Alexhuge1/fftai_alexbotmini/1_Mechanic/Alexbotmini_V1.0/back.jpg

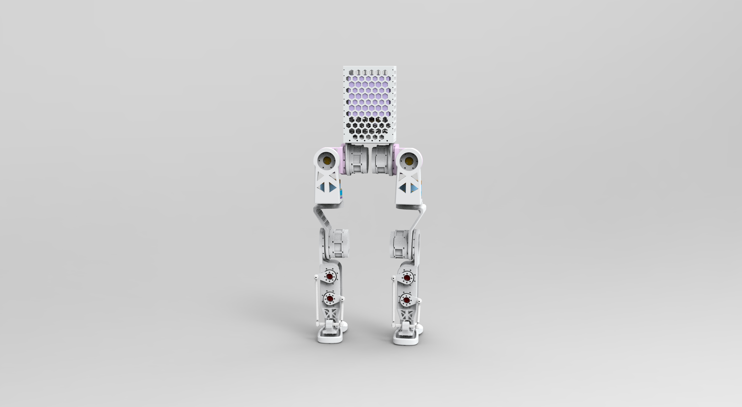
1_Mechanic/Alexbotmini_V1.0/back.jpg
