Alexhuge1/fftai_alexbotmini/1_Mechanic/Alexbotmini_V1.0/CNCchange/crotch修改.png

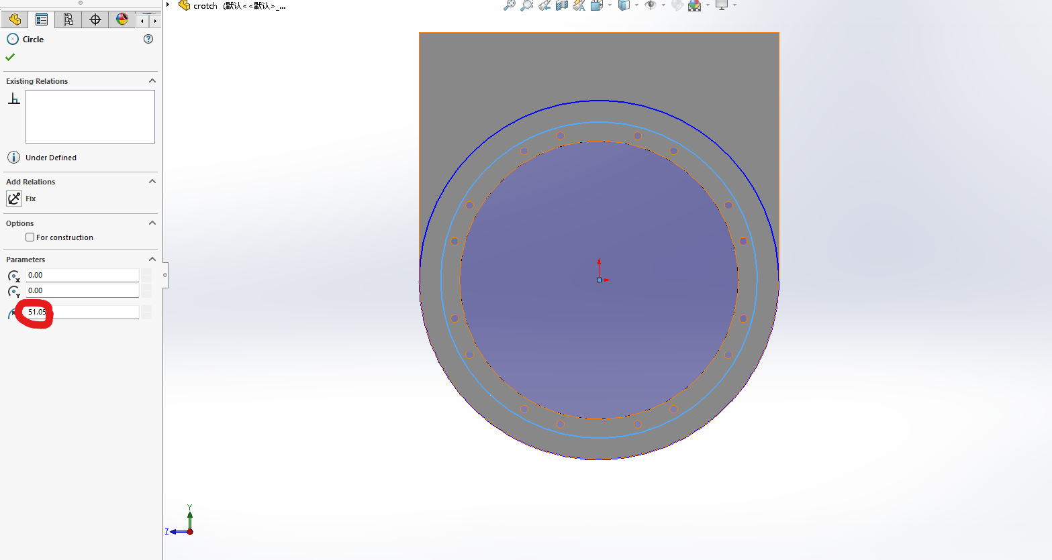
1_Mechanic/Alexbotmini_V1.0/CNCchange/crotch修改.png
