Alexhuge1/fftai_alexbotmini/1_Mechanic/Alexbotmini_V1.0/CNCchange/fsa60修改.png

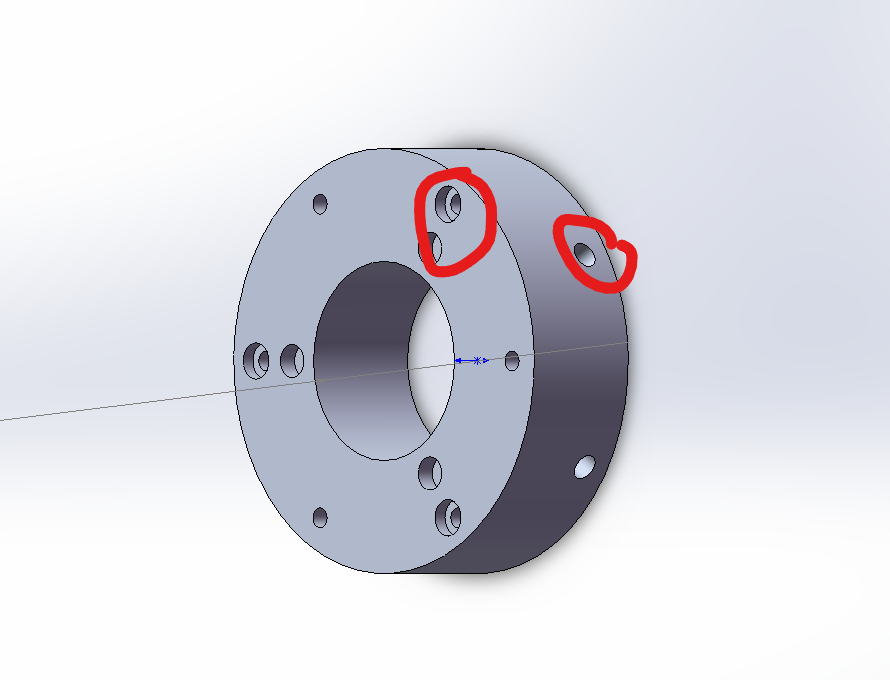
1_Mechanic/Alexbotmini_V1.0/CNCchange/fsa60修改.png
