Alexhuge1/fftai_alexbotmini/1_Mechanic/Alexbotmini_V1.0/for_cnc(unchanged)/SW转PDF字体/软件安装教程、详细安装方法.png

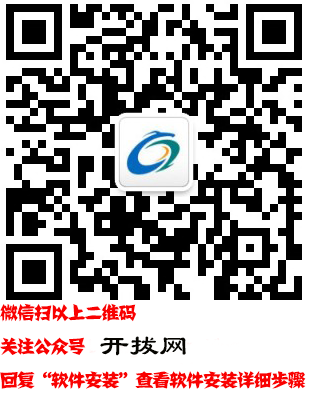
1_Mechanic/Alexbotmini_V1.0/for_cnc(unchanged)/SW转PDF字体/软件安装教程、详细安装方法.png
