Alexhuge1/fftai_alexbotmini/1_Mechanic/Alexbotmini_V1.0/upperbody(without yaw)/电路模型/48v转5v/转压.png

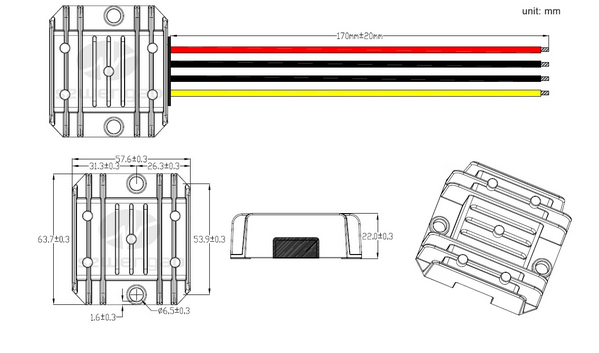
1_Mechanic/Alexbotmini_V1.0/upperbody(without yaw)/电路模型/48v转5v/转压.png
