Alexhuge1/fftai_alexbotmini/1_Mechanic/Alexbotmini_V1.0/upperbody(without yaw)/电路模型/imu/屏幕截图 2024-09-07 170201.png

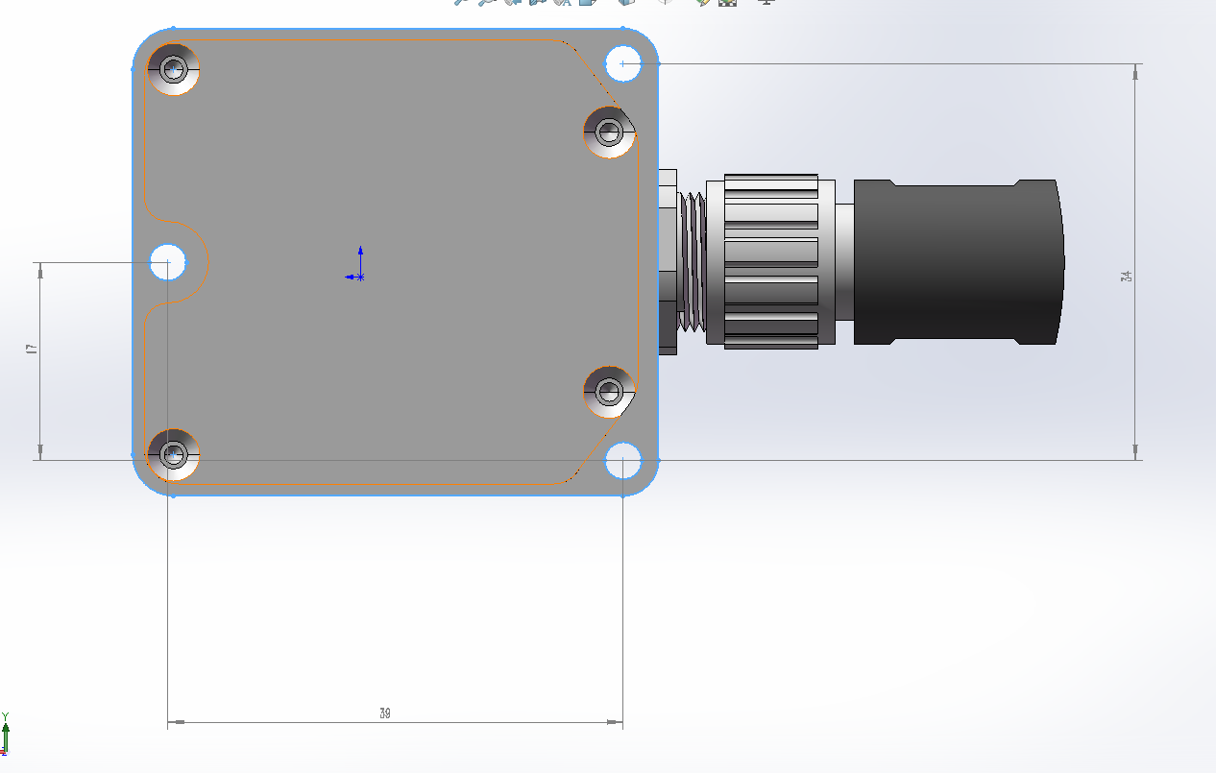
1_Mechanic/Alexbotmini_V1.0/upperbody(without yaw)/电路模型/imu/屏幕截图 2024-09-07 170201.png
