Alexhuge1/fftai_alexbotmini/1_Mechanic/Alexbotmini_V1.0/upperbody(without yaw)/电路模型/上位机/jetsonnano.png

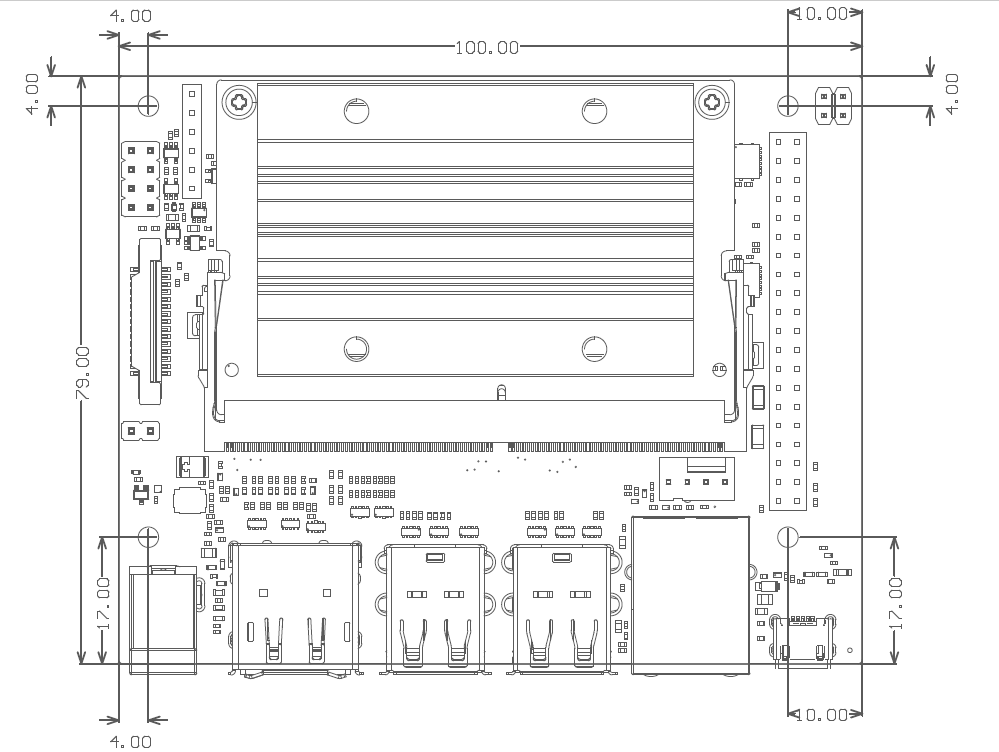
1_Mechanic/Alexbotmini_V1.0/upperbody(without yaw)/电路模型/上位机/jetsonnano.png
