Alexhuge1/fftai_alexbotmini/1_Mechanic/alexbotminipage/keyshot.23/files/xr_cursor.gif

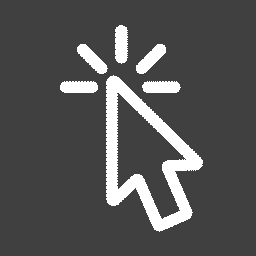
1_Mechanic/alexbotminipage/keyshot.23/files/xr_cursor.gif
