Alexhuge1/fftai_alexbotmini/2_Firmware/joystick/ps5手柄.jpg

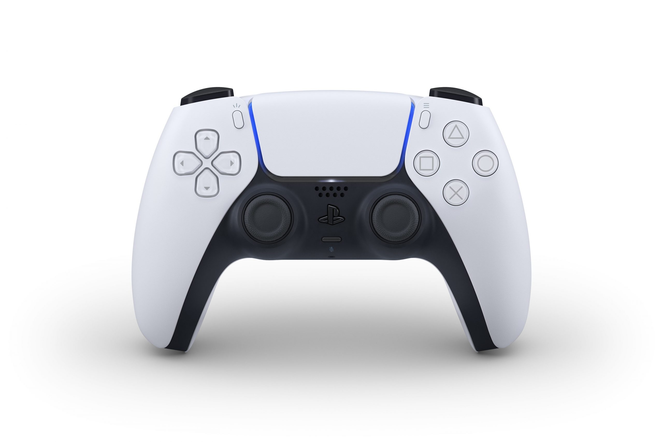
2_Firmware/joystick/ps5手柄.jpg
