Alexhuge1/fftai_alexbotmini/6_Photos/alexbotmini(3D).jpg

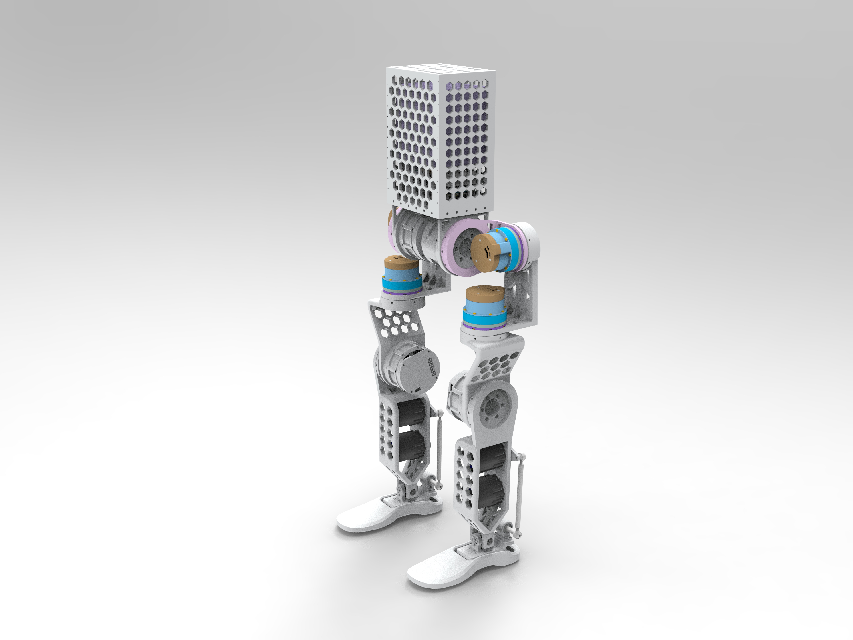
6_Photos/alexbotmini(3D).jpg
