Alexhuge1/fftai_alexbotmini/6_Photos/alexbotmini_stand.jpg

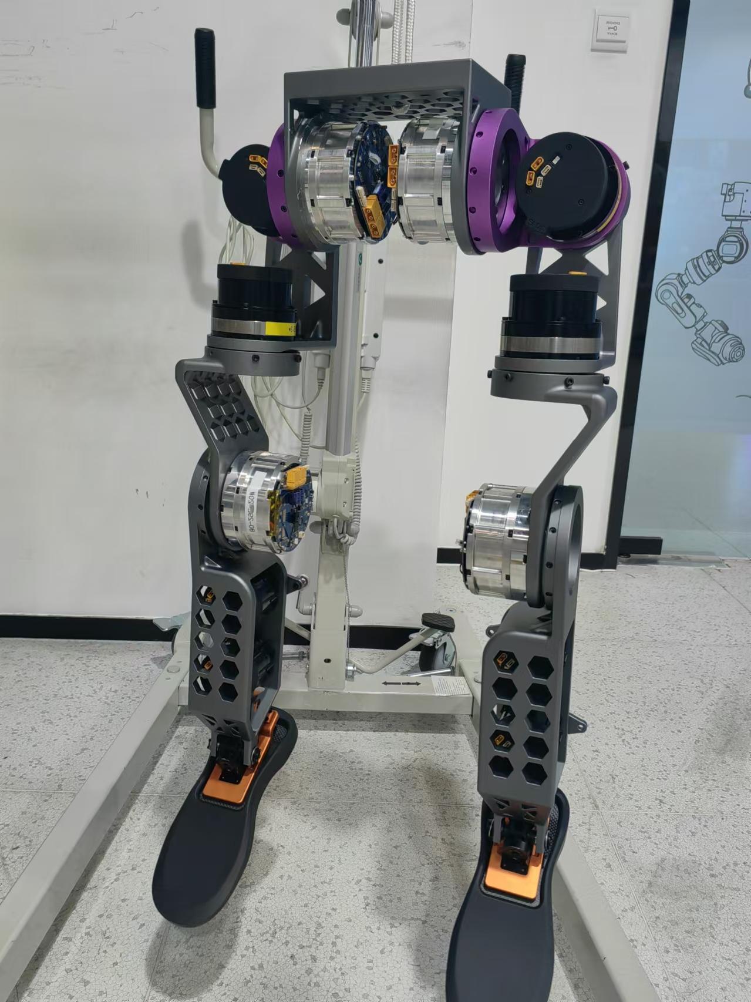
6_Photos/alexbotmini_stand.jpg
