Alexhuge1/fftai_alexbotmini/6_Photos/V1lowerbody.jpg

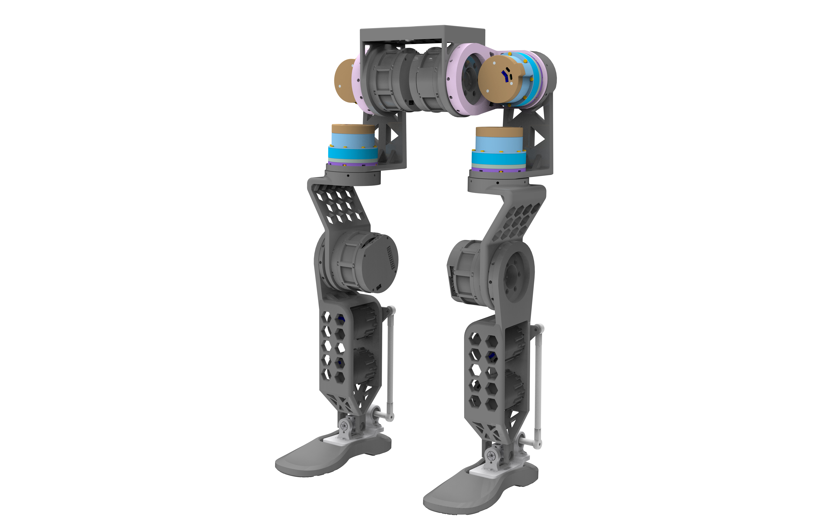
6_Photos/V1lowerbody.jpg
