Alexhuge1/fftai_alexbotmini/6_Photos/身高尺寸图.png

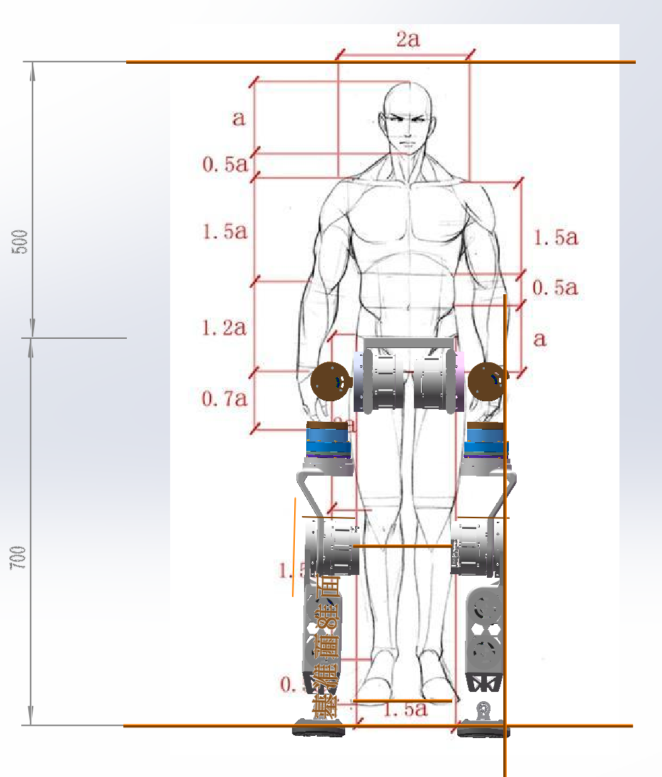
6_Photos/身高尺寸图.png
