Alexhuge1/fftai_alexbotmini/1_Mechanic/alexbotmini_urdf/alexbotmini/meshes/leftlink4.STL

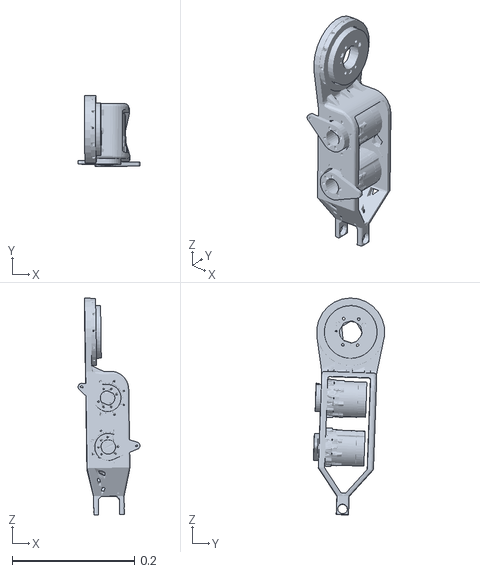
[picture p39: CAD file, 2024-08-29]
1_Mechanic/alexbotmini_urdf/alexbotmini/meshes/leftlink4.STL
0.101 x 0.116 x 0.355
