Alexhuge1/fftai_alexbotmini/1_Mechanic/Alexbotmini_V1.0/CNCchange/crotch.STEP

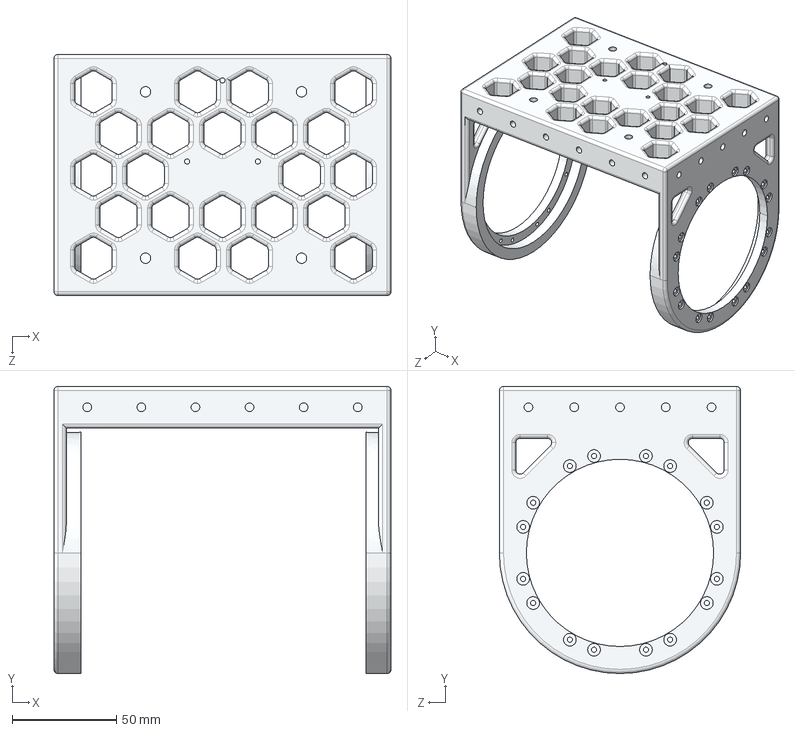
[picture p40: CAD file, 2024-12-02]
1_Mechanic/Alexbotmini_V1.0/CNCchange/crotch.STEP
162.0 x 138.0 x 116.0 mm
