Alexhuge1/fftai_alexbotmini/1_Mechanic/Alexbotmini_V1.0/for_cnc(unchanged)/3D/back.SLDPRT

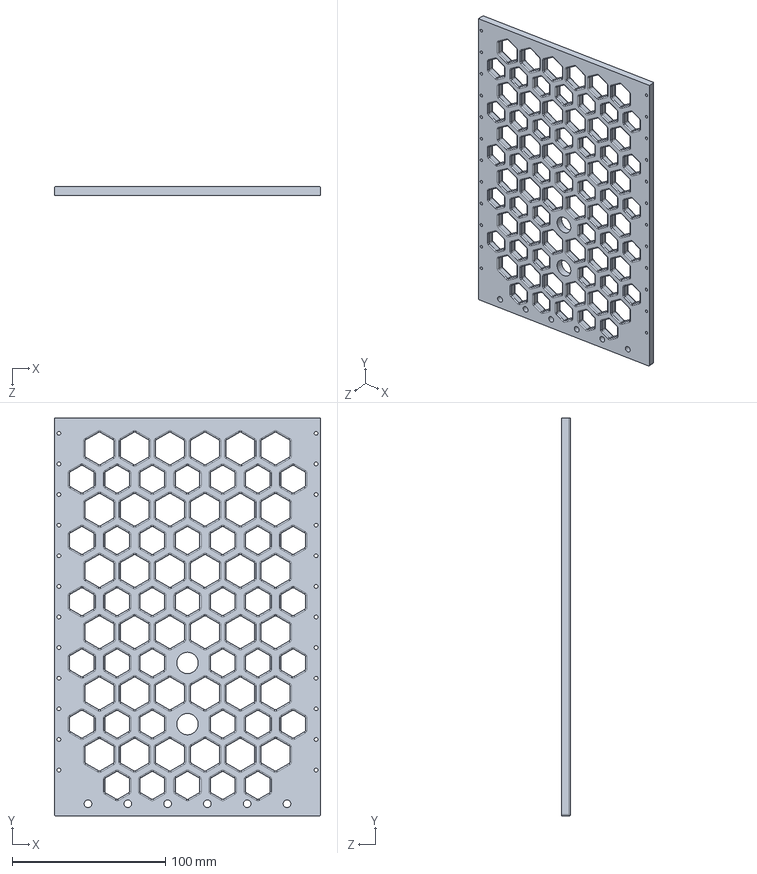
[picture p41: CAD file, 2024-09-12]
1_Mechanic/Alexbotmini_V1.0/for_cnc(unchanged)/3D/back.SLDPRT
174.0 x 260.0 x 6.00 mm
