Alexhuge1/fftai_alexbotmini/1_Mechanic/Alexbotmini_V1.0/upperbody(without yaw)/front.SLDPRT

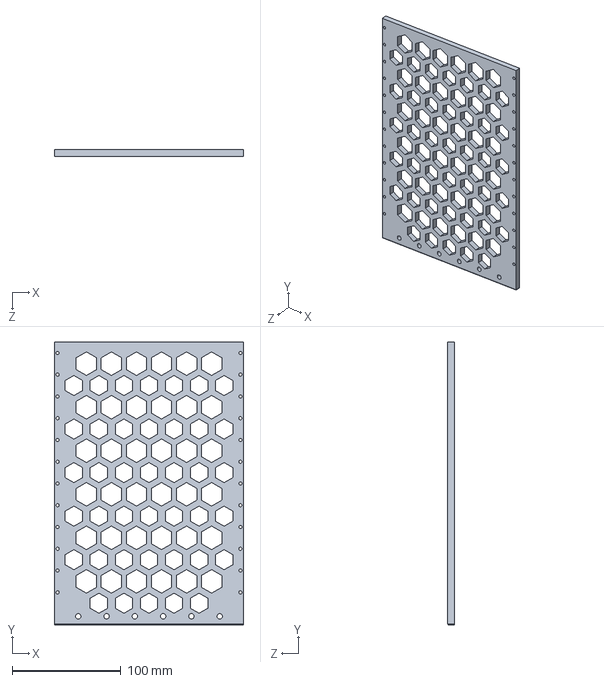
[picture p42: CAD file, 2024-09-10]
1_Mechanic/Alexbotmini_V1.0/upperbody(without yaw)/front.SLDPRT
174.0 x 260.0 x 6.00 mm
