Alexhuge1/fftai_alexbotmini/1_Mechanic/Alexbotmini_V1.0/upperbody(without yaw)/电路模型/48v转5v/转压.SLDPRT

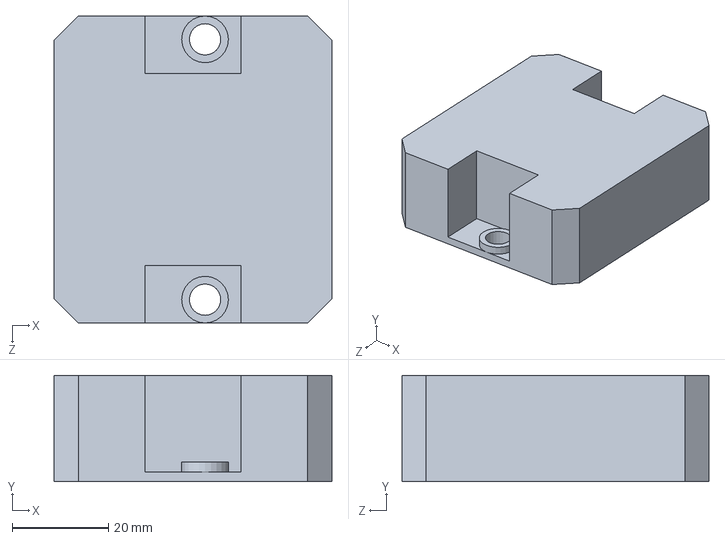
[picture p43: CAD file, 2024-09-09]
1_Mechanic/Alexbotmini_V1.0/upperbody(without yaw)/电路模型/48v转5v/转压.SLDPRT
57.6 x 22.0 x 63.7 mm
