Alexhuge1/fftai_alexbotmini/1_Mechanic/Alexbotmini_V1.0/upperbody(without yaw)/电路模型/imu/imu.SLDPRT

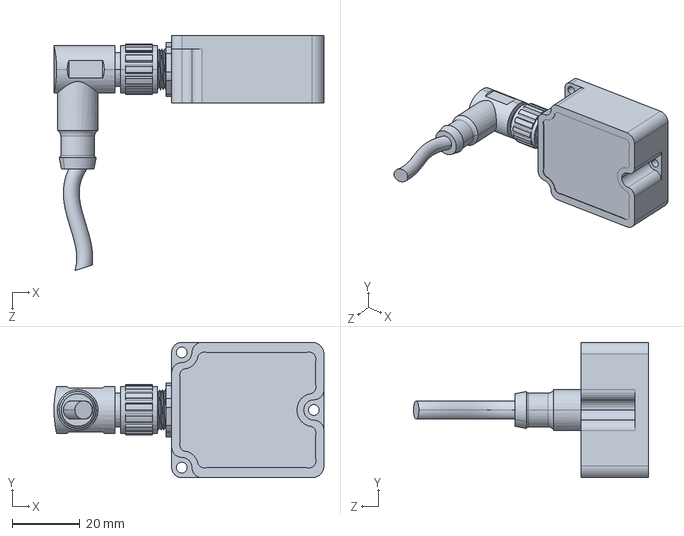
[picture p44: CAD file, 2024-09-09]
1_Mechanic/Alexbotmini_V1.0/upperbody(without yaw)/电路模型/imu/imu.SLDPRT
79.8 x 40.0 x 69.5 mm
