Alexhuge1/fftai_alexbotmini/1_Mechanic/Alexbotmini_V1.0/upperbody(without yaw)/电路模型/上位机/螺柱.SLDPRT

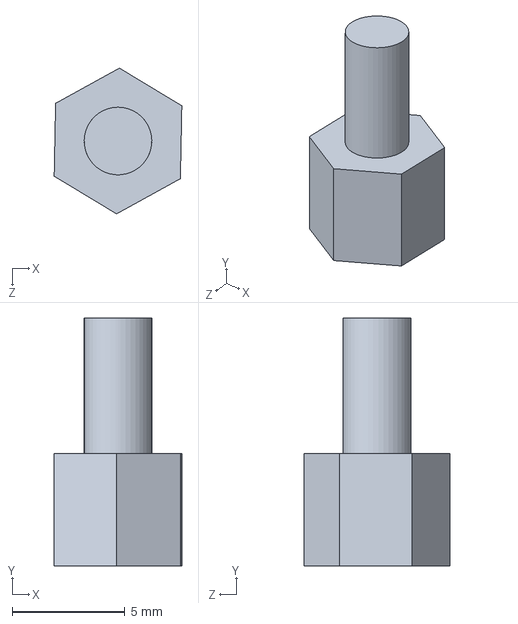
[picture p45: CAD file, 2024-09-09]
1_Mechanic/Alexbotmini_V1.0/upperbody(without yaw)/电路模型/上位机/螺柱.SLDPRT
5.66 x 11.0 x 6.47 mm
