Alexhuge1/fftai_alexbotmini/1_Mechanic/Alexbotmini_V1.0/wholebody/thigh2.SLDPRT

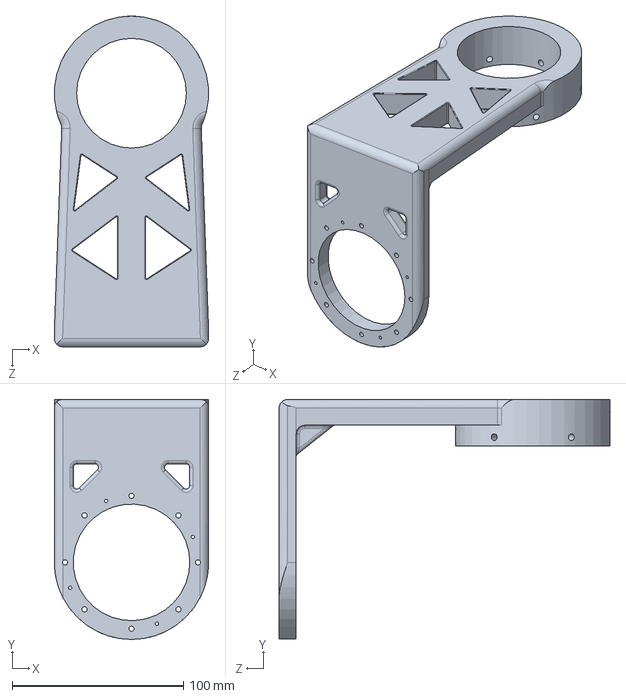
[picture p46: CAD file, 2024-11-27]
1_Mechanic/Alexbotmini_V1.0/wholebody/thigh2.SLDPRT
90.0 x 140.0 x 193.0 mm
