Alexhuge1/fftai_alexbotmini/3_Walk and trot/humanoid-gym/resources/robots/alexbotmini/meshes/base_link.STL

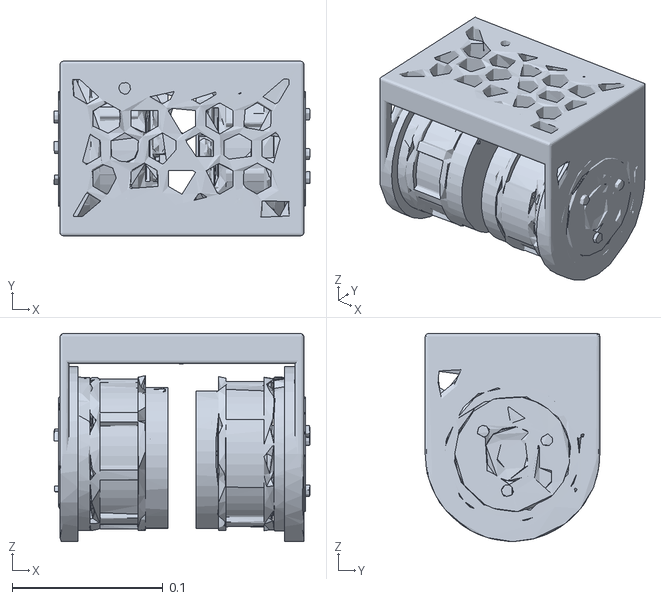
[picture p47: CAD file, 2024-08-29]
3_Walk and trot/humanoid-gym/resources/robots/alexbotmini/meshes/base_link.STL
0.17 x 0.116 x 0.138
