Alexhuge1/fftai_alexbotmini/3_Walk and trot/humanoid-gym/resources/robots/XBot/meshes/left_ankle_roll_link.STL

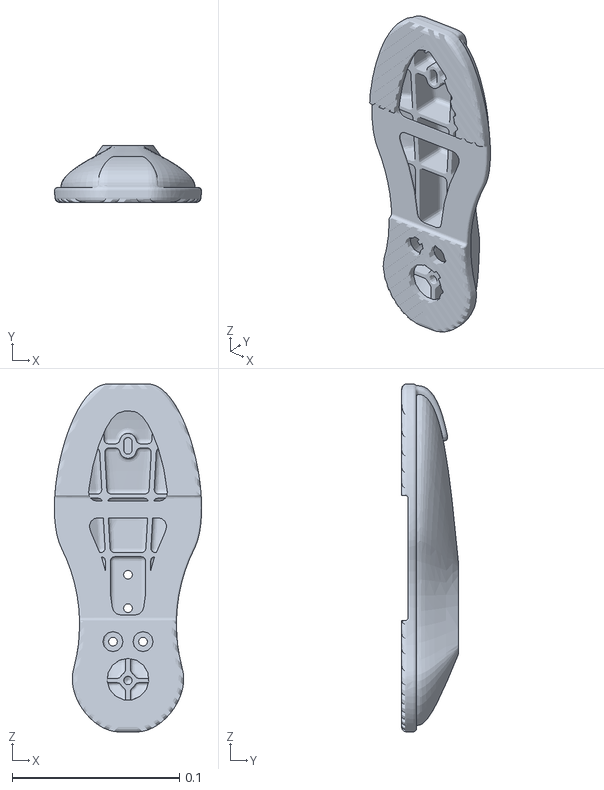
[picture p48: CAD file, 2024-08-29]
3_Walk and trot/humanoid-gym/resources/robots/XBot/meshes/left_ankle_roll_link.STL
0.088 x 0.034 x 0.208
