Alexhuge1/fftai_alexbotmini/3_Walk and trot/humanoid-gym/resources/robots/XBot/urdf/right_hand_ring_tip.STL

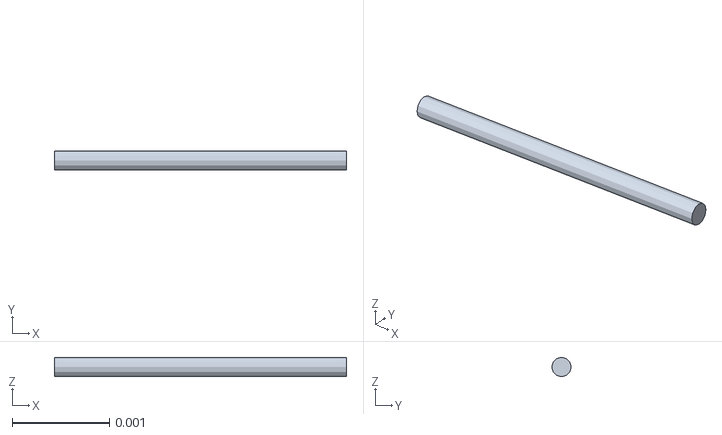
[picture p49: CAD file, 2024-08-29]
3_Walk and trot/humanoid-gym/resources/robots/XBot/urdf/right_hand_ring_tip.STL
0.003 x 0.0002 x 0.0002
