Alexhuge1/fftai_alexbotmini/1_Mechanic/alexbotmini_urdf/alexbotmini/meshes/leftlink2.STL

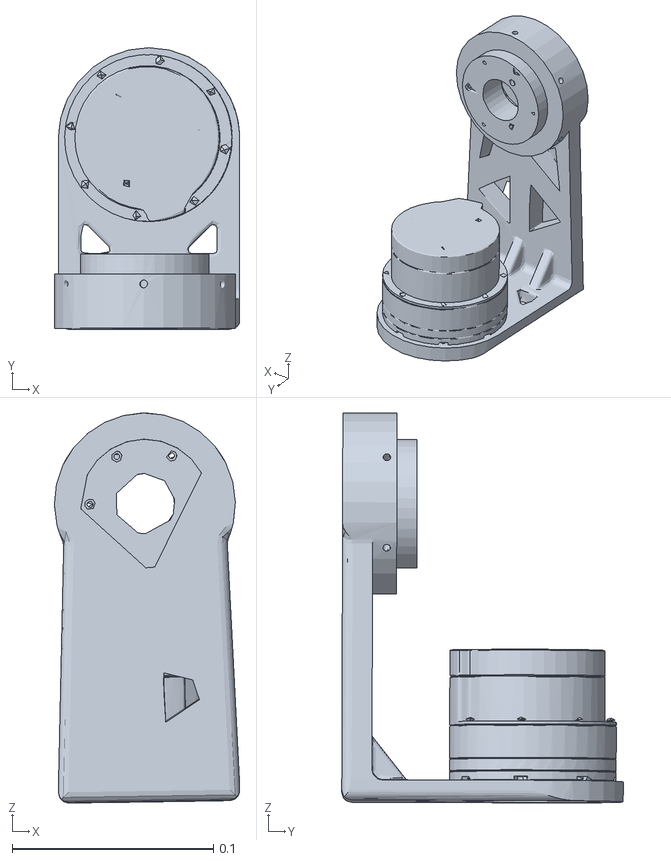
[picture p50: CAD file, 2024-08-29]
1_Mechanic/alexbotmini_urdf/alexbotmini/meshes/leftlink2.STL
0.0921 x 0.14 x 0.194
