Alexhuge1/fftai_alexbotmini/1_Mechanic/Alexbotmini_V1.0/CNCchange/fsa60_43e_output.STEP

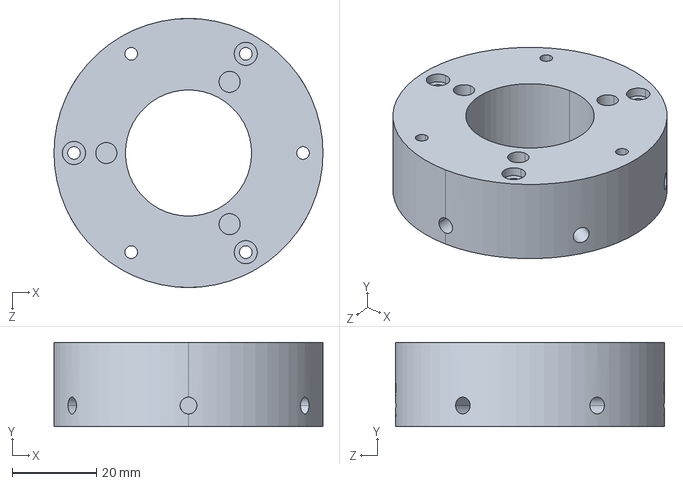
[picture p51: CAD file, 2024-12-02]
1_Mechanic/Alexbotmini_V1.0/CNCchange/fsa60_43e_output.STEP
64.0 x 20.0 x 64.0 mm
