Alexhuge1/fftai_alexbotmini/1_Mechanic/Alexbotmini_V1.0/for_cnc(unchanged)/step/calf1.step

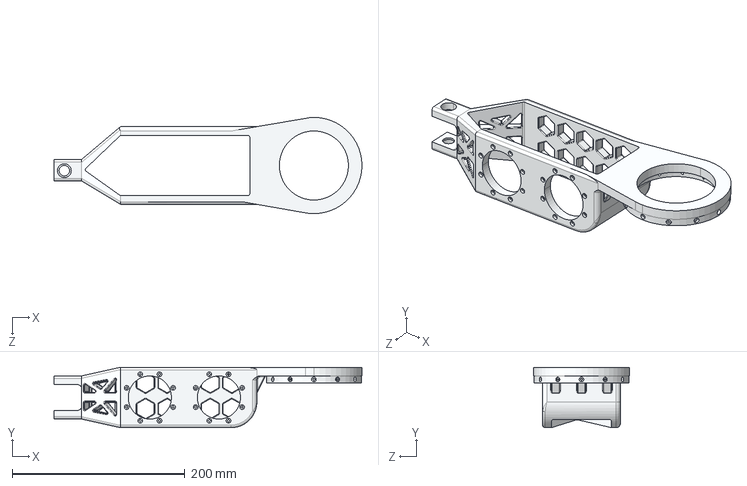
[picture p52: CAD file, 2024-09-12]
1_Mechanic/Alexbotmini_V1.0/for_cnc(unchanged)/step/calf1.step
356.7 x 70.0 x 111.4 mm
