Alexhuge1/fftai_alexbotmini/3_Walk and trot/humanoid-gym/resources/robots/XBot/meshes/left_leg_roll_link.STL

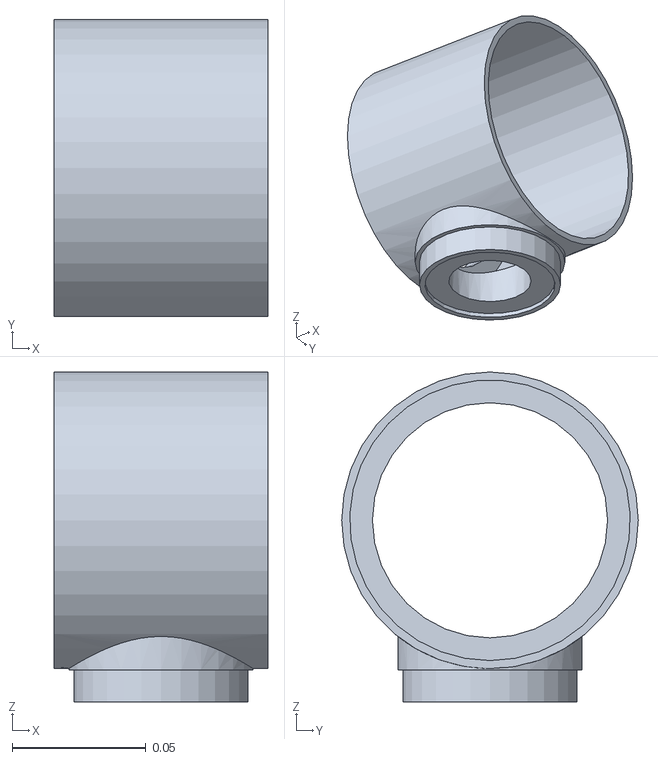
[picture p53: CAD file, 2024-08-29]
3_Walk and trot/humanoid-gym/resources/robots/XBot/meshes/left_leg_roll_link.STL
0.08 x 0.111 x 0.124
