Alexhuge1/fftai_alexbotmini/3_Walk and trot/humanoid-gym/resources/robots/XBot/urdf/right_hand_mid_link2.STL

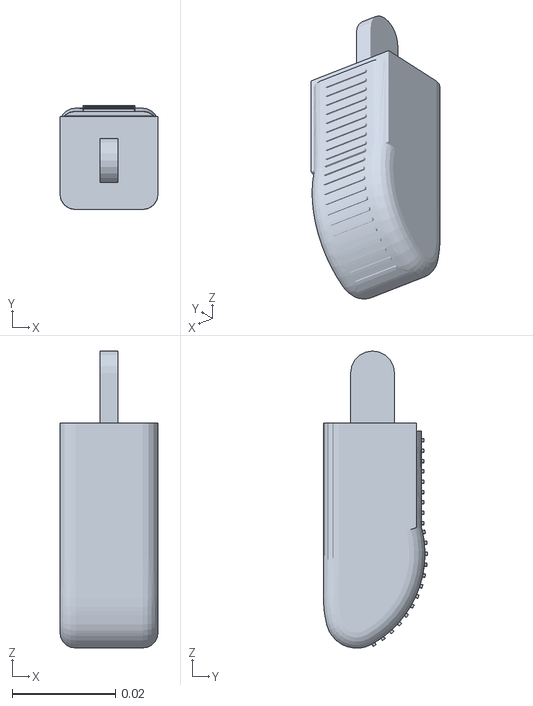
[picture p54: CAD file, 2024-08-29]
3_Walk and trot/humanoid-gym/resources/robots/XBot/urdf/right_hand_mid_link2.STL
0.019 x 0.0201 x 0.0575
