Alexhuge1/fftai_alexbotmini/1_Mechanic/alexbotmini_urdf/alexbotmini/meshes/leftlink3.STL

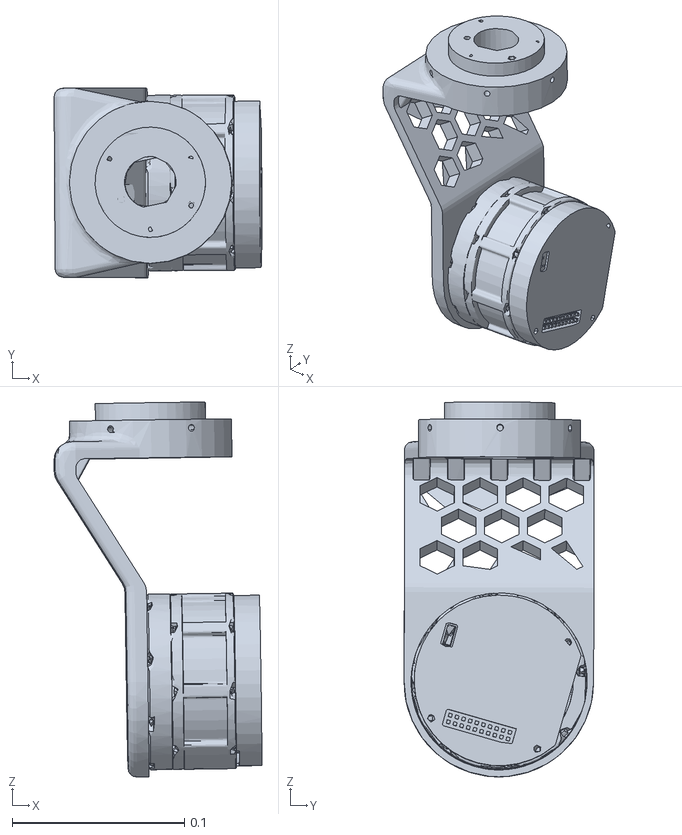
[picture p55: CAD file, 2024-08-29]
1_Mechanic/alexbotmini_urdf/alexbotmini/meshes/leftlink3.STL
0.121 x 0.11 x 0.218
