Alexhuge1/fftai_alexbotmini/1_Mechanic/Alexbotmini_V1.0/for_cnc(unchanged)/3D/top.SLDPRT

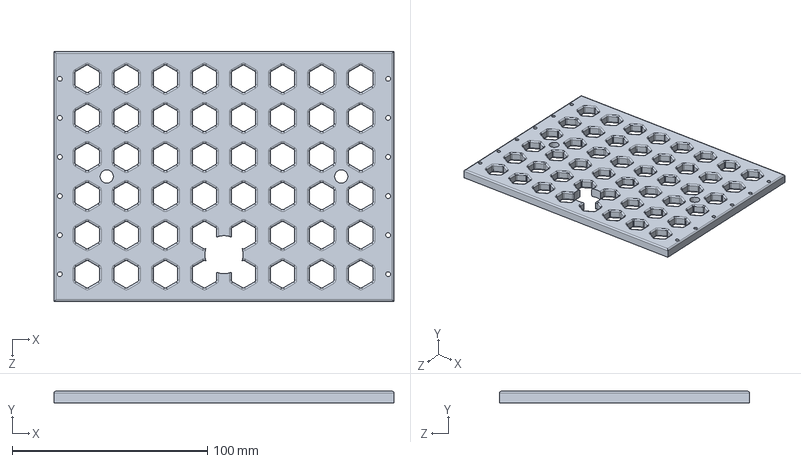
[picture p56: CAD file, 2024-09-12]
1_Mechanic/Alexbotmini_V1.0/for_cnc(unchanged)/3D/top.SLDPRT
174.0 x 6.00 x 128.0 mm
