Alexhuge1/fftai_alexbotmini/1_Mechanic/Alexbotmini_V1.0/for_cnc(unchanged)/step/fsa45_30_output.step

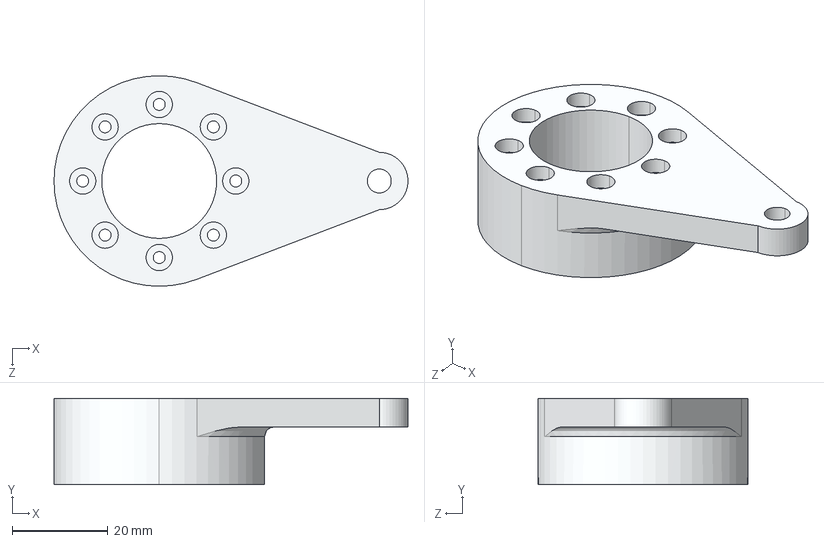
[picture p57: CAD file, 2024-09-12]
1_Mechanic/Alexbotmini_V1.0/for_cnc(unchanged)/step/fsa45_30_output.step
74.0 x 18.0 x 44.0 mm
