Alexhuge1/fftai_alexbotmini/1_Mechanic/Alexbotmini_V1.0/upperbody(without yaw)/M3螺柱10.SLDPRT

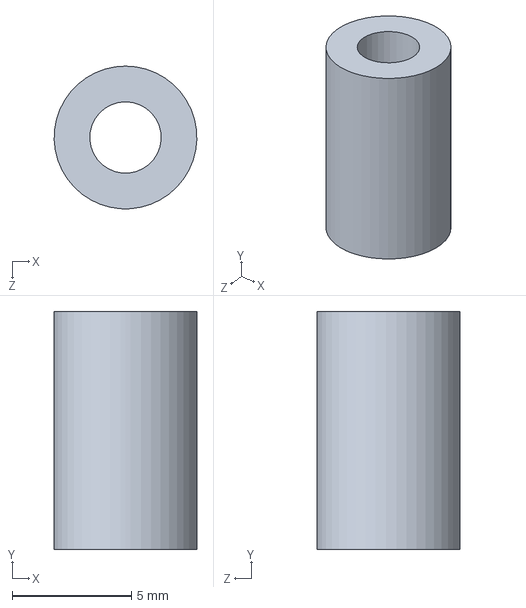
[picture p58: CAD file, 2024-09-10]
1_Mechanic/Alexbotmini_V1.0/upperbody(without yaw)/M3螺柱10.SLDPRT
6.00 x 10.0 x 6.00 mm
