Alexhuge1/fftai_alexbotmini/3_Walk and trot/humanoid-gym/resources/robots/XBot/meshes/left_ankle_pitch_motor2_link.STL

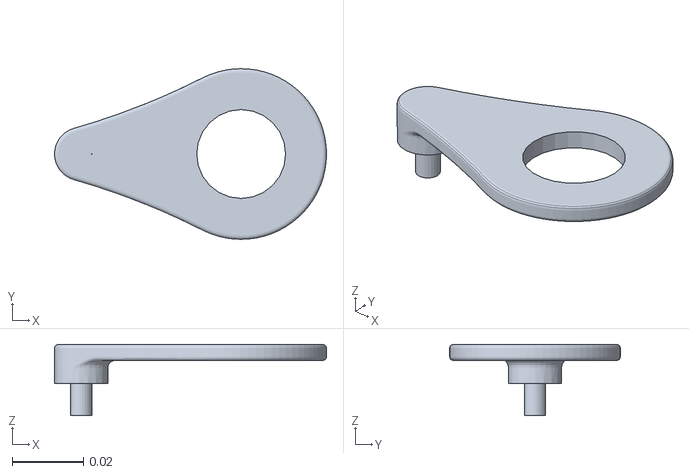
[picture p59: CAD file, 2024-08-29]
3_Walk and trot/humanoid-gym/resources/robots/XBot/meshes/left_ankle_pitch_motor2_link.STL
0.0765 x 0.048 x 0.02
