Alexhuge1/fftai_alexbotmini/1_Mechanic/alexbotmini_urdf/alexbotmini/meshes/leftlink5.STL

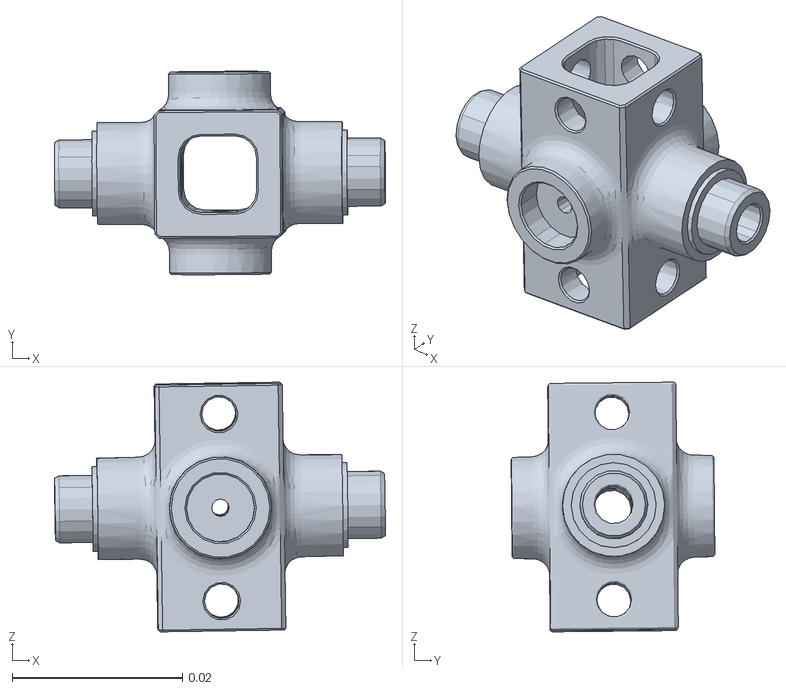
[picture p60: CAD file, 2024-08-29]
1_Mechanic/alexbotmini_urdf/alexbotmini/meshes/leftlink5.STL
0.0389 x 0.0239 x 0.0294
