Alexhuge1/fftai_alexbotmini/1_Mechanic/Alexbotmini_V1.0/CNCchange/thigh1.STEP

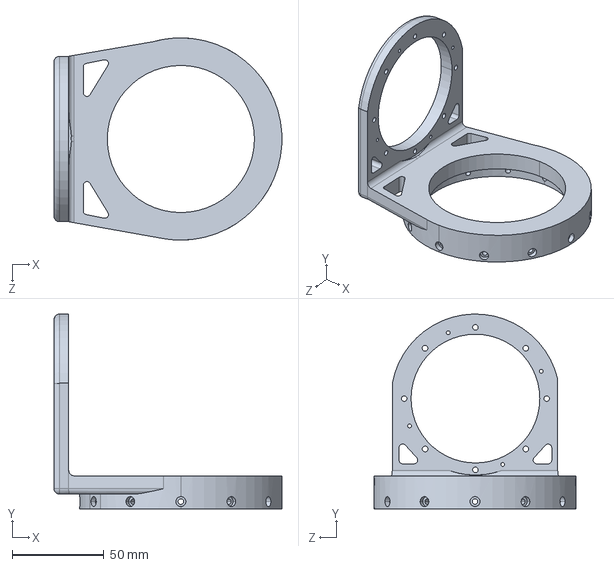
[picture p61: CAD file, 2024-12-02]
1_Mechanic/Alexbotmini_V1.0/CNCchange/thigh1.STEP
124.0 x 106.0 x 110.0 mm
