Alexhuge1/fftai_alexbotmini/1_Mechanic/Alexbotmini_V1.0/for_cnc(unchanged)/3D/right.SLDPRT

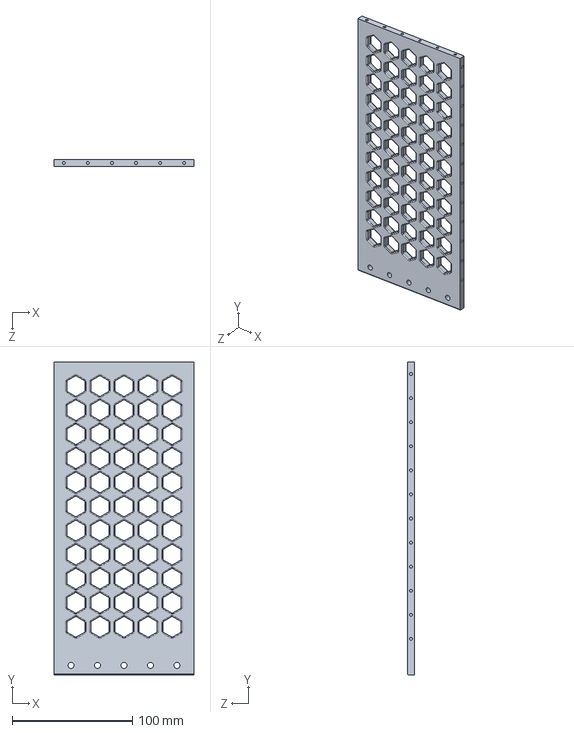
[picture p62: CAD file, 2024-09-12]
1_Mechanic/Alexbotmini_V1.0/for_cnc(unchanged)/3D/right.SLDPRT
116.0 x 260.0 x 6.00 mm
