Alexhuge1/fftai_alexbotmini/1_Mechanic/Alexbotmini_V1.0/for_cnc(unchanged)/step/fsa80_29e_output_long.step

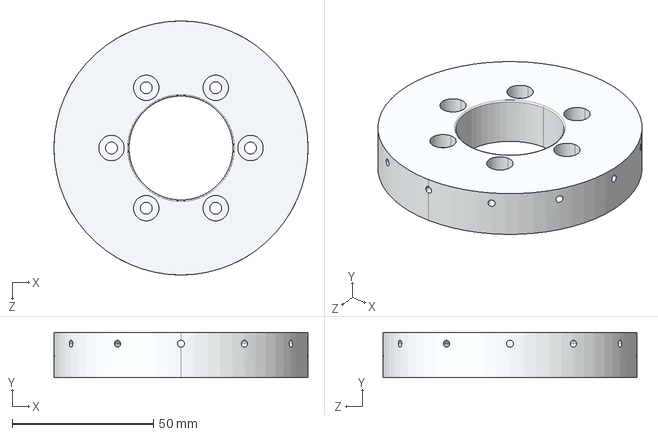
[picture p63: CAD file, 2024-09-12]
1_Mechanic/Alexbotmini_V1.0/for_cnc(unchanged)/step/fsa80_29e_output_long.step
89.9 x 16.0 x 89.9 mm
