Alexhuge1/fftai_alexbotmini/1_Mechanic/Alexbotmini_V1.0/wholebody/fsa80_29e_output.SLDPRT

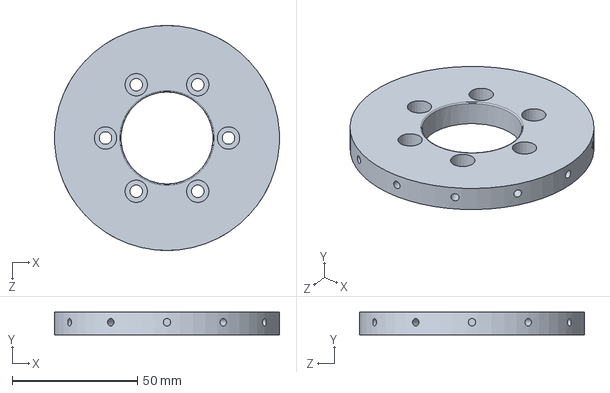
[picture p64: CAD file, 2024-10-09]
1_Mechanic/Alexbotmini_V1.0/wholebody/fsa80_29e_output.SLDPRT
90.0 x 9.00 x 90.0 mm
