Alexhuge1/fftai_alexbotmini/3_Walk and trot/humanoid-gym/resources/robots/XBot/meshes/right_knee_motor_link.STL

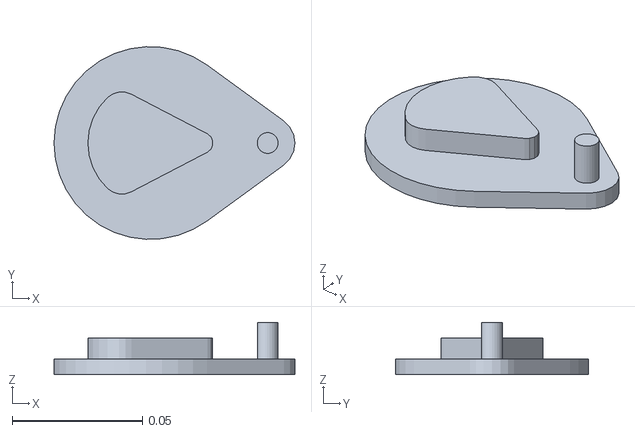
[picture p65: CAD file, 2024-08-29]
3_Walk and trot/humanoid-gym/resources/robots/XBot/meshes/right_knee_motor_link.STL
0.0925 x 0.0739 x 0.02
