Alexhuge1/fftai_alexbotmini/3_Walk and trot/humanoid-gym/resources/robots/XBot/urdf/right_hand_thumb_bend_link.STL

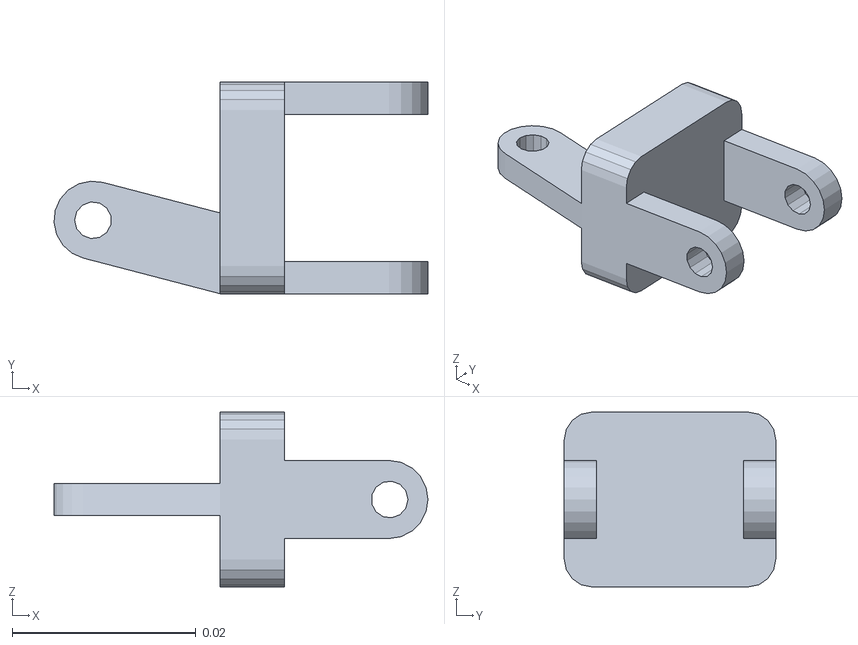
[picture p66: CAD file, 2024-08-29]
3_Walk and trot/humanoid-gym/resources/robots/XBot/urdf/right_hand_thumb_bend_link.STL
0.0407 x 0.023 x 0.019
