Alexhuge1/fftai_alexbotmini/1_Mechanic/alexbotmini_urdf/alexbotmini/meshes/rightlink2.STL

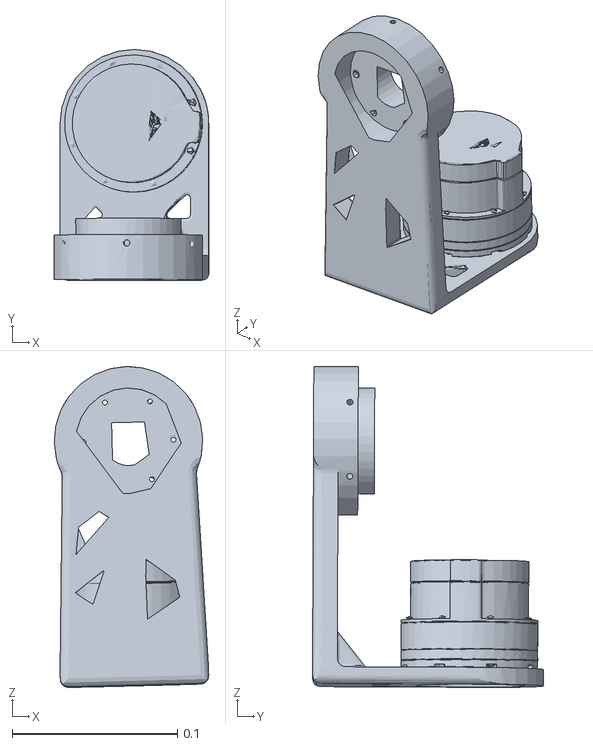
[picture p67: CAD file, 2024-08-29]
1_Mechanic/alexbotmini_urdf/alexbotmini/meshes/rightlink2.STL
0.0936 x 0.14 x 0.194
