Alexhuge1/fftai_alexbotmini/1_Mechanic/Alexbotmini_V1.0/upperbody(without yaw)/M4螺柱6.SLDPRT

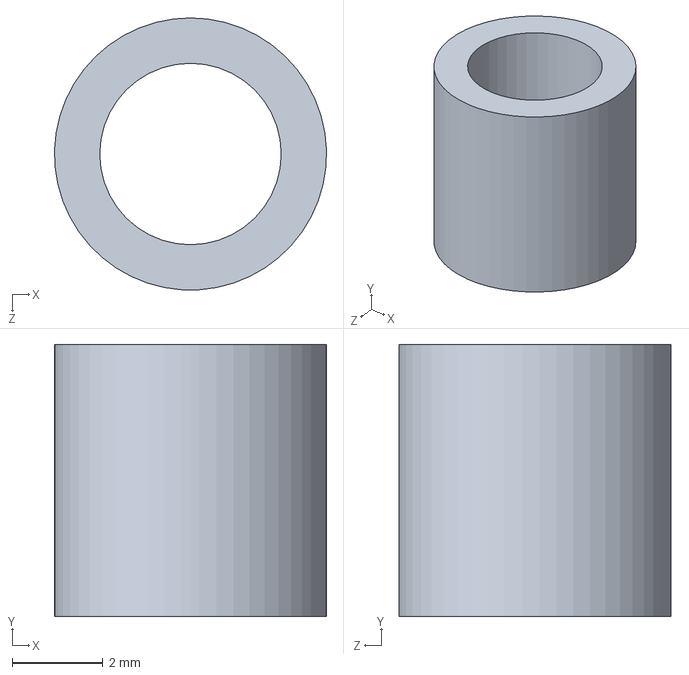
[picture p69: CAD file, 2024-09-10]
1_Mechanic/Alexbotmini_V1.0/upperbody(without yaw)/M4螺柱6.SLDPRT
6.00 x 6.00 x 6.00 mm
