Alexhuge1/fftai_alexbotmini/3_Walk and trot/humanoid-gym/resources/robots/XBot/meshes/right_leg_pitch_link.STL

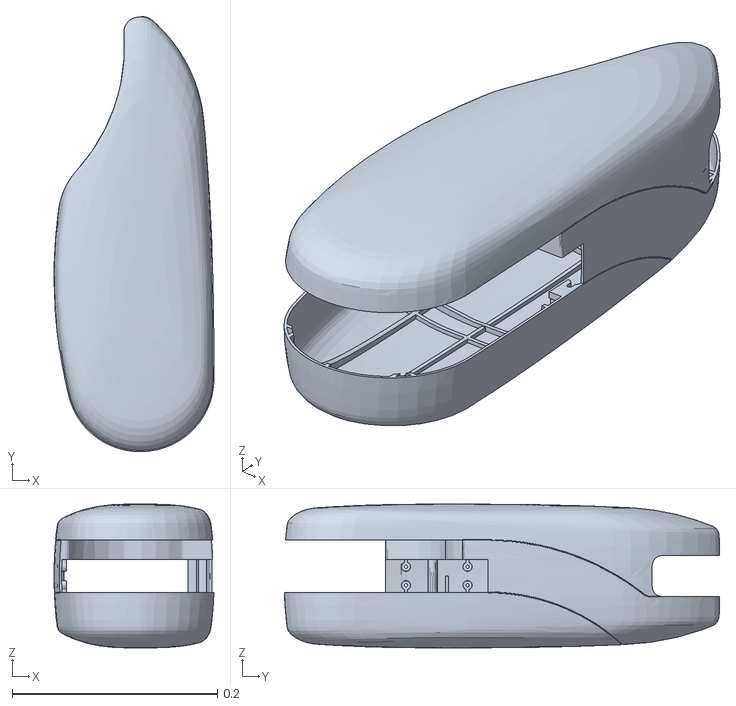
[picture p70: CAD file, 2024-08-29]
3_Walk and trot/humanoid-gym/resources/robots/XBot/meshes/right_leg_pitch_link.STL
0.156 x 0.425 x 0.14
