Alexhuge1/fftai_alexbotmini/3_Walk and trot/humanoid-gym/resources/robots/XBot/urdf/right_wrist_yaw_link.STL

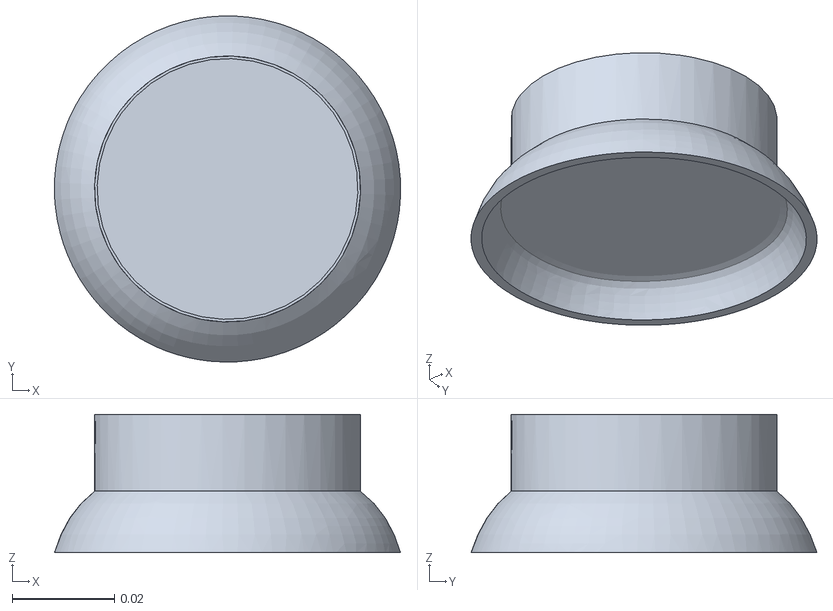
[picture p71: CAD file, 2024-08-29]
3_Walk and trot/humanoid-gym/resources/robots/XBot/urdf/right_wrist_yaw_link.STL
0.0677 x 0.0677 x 0.027
