Alexhuge1/fftai_alexbotmini/1_Mechanic/Alexbotmini_V1.0/for_cnc(unchanged)/3D/ctrlbox.SLDPRT

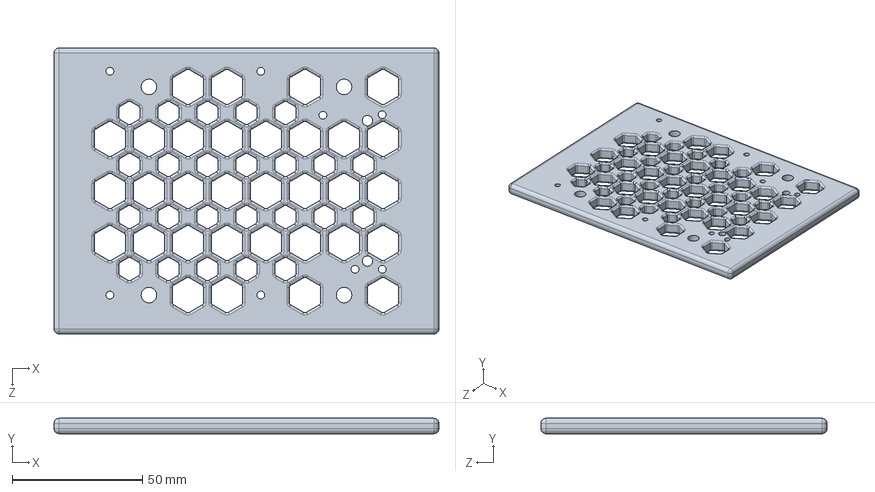
[picture p73: CAD file, 2024-09-10]
1_Mechanic/Alexbotmini_V1.0/for_cnc(unchanged)/3D/ctrlbox.SLDPRT
148.0 x 6.00 x 110.0 mm
