Alexhuge1/fftai_alexbotmini/1_Mechanic/Alexbotmini_V1.0/for_cnc(unchanged)/step/fsa80_29e_output.step

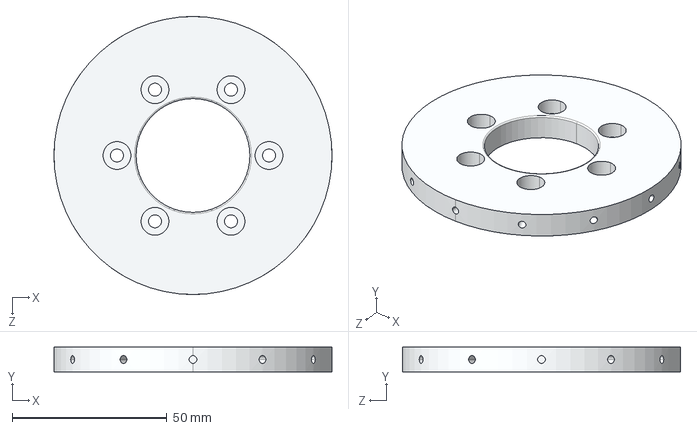
[picture p74: CAD file, 2024-09-12]
1_Mechanic/Alexbotmini_V1.0/for_cnc(unchanged)/step/fsa80_29e_output.step
90.0 x 8.00 x 90.0 mm
