Alexhuge1/fftai_alexbotmini/1_Mechanic/Alexbotmini_V1.0/upperbody(without yaw)/M3螺柱25.SLDPRT

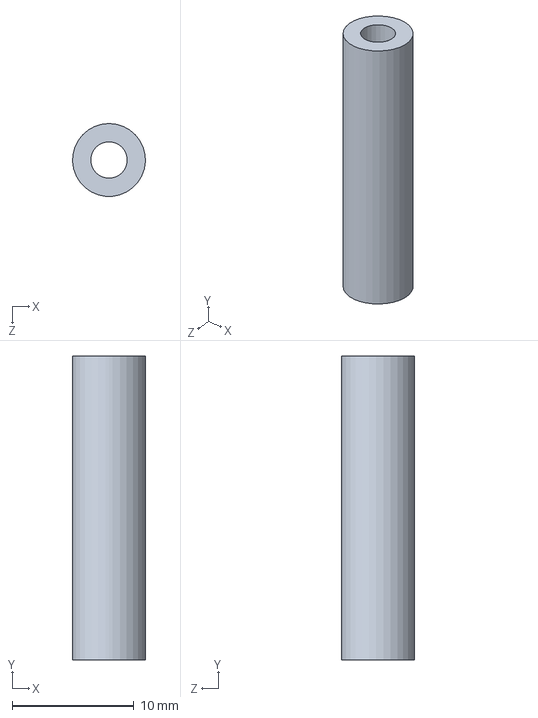
[picture p75: CAD file, 2024-09-10]
1_Mechanic/Alexbotmini_V1.0/upperbody(without yaw)/M3螺柱25.SLDPRT
5.99 x 25.0 x 6.00 mm
