Alexhuge1/fftai_alexbotmini/3_Walk and trot/humanoid-gym/resources/robots/XBot/meshes/right_elbow_pitch_link.STL

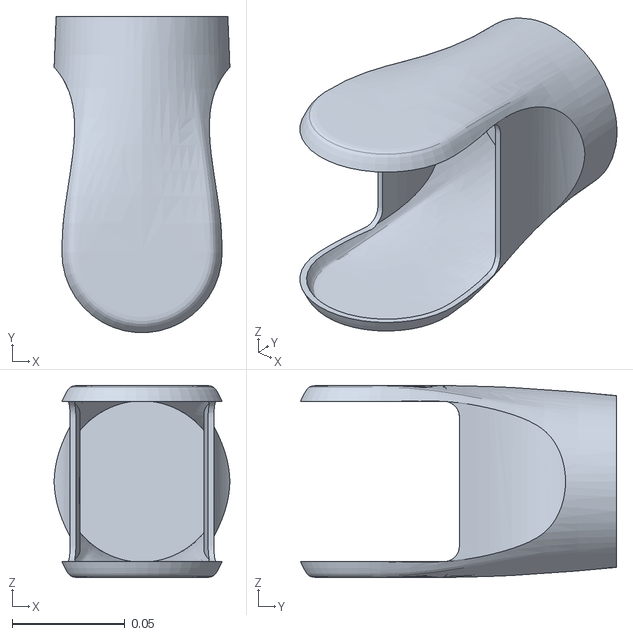
[picture p76: CAD file, 2024-08-29]
3_Walk and trot/humanoid-gym/resources/robots/XBot/meshes/right_elbow_pitch_link.STL
0.0778 x 0.14 x 0.085
