Alexhuge1/fftai_alexbotmini/3_Walk and trot/humanoid-gym/resources/robots/XBot/urdf/neck_base_link.STL

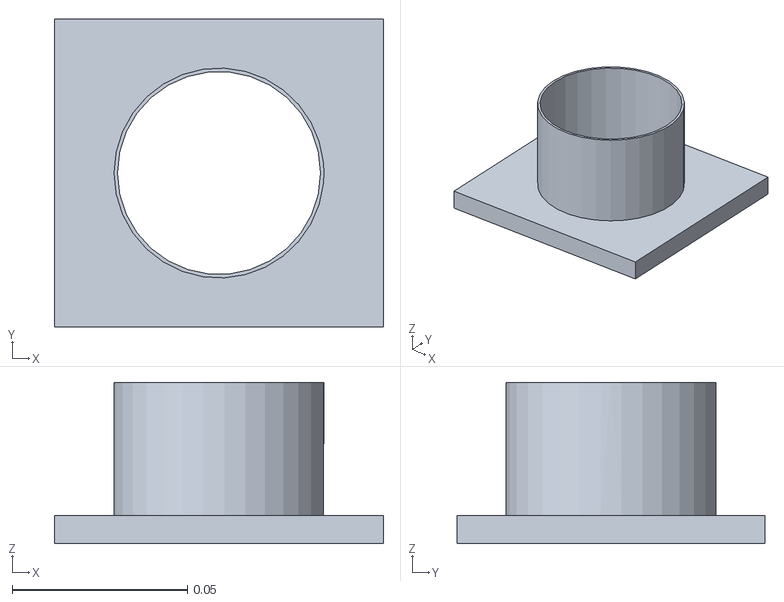
[picture p77: CAD file, 2024-08-29]
3_Walk and trot/humanoid-gym/resources/robots/XBot/urdf/neck_base_link.STL
0.094 x 0.088 x 0.046
