Alexhuge1/fftai_alexbotmini/1_Mechanic/Alexbotmini_V1.0/upperbody(without yaw)/M6螺柱35.SLDPRT

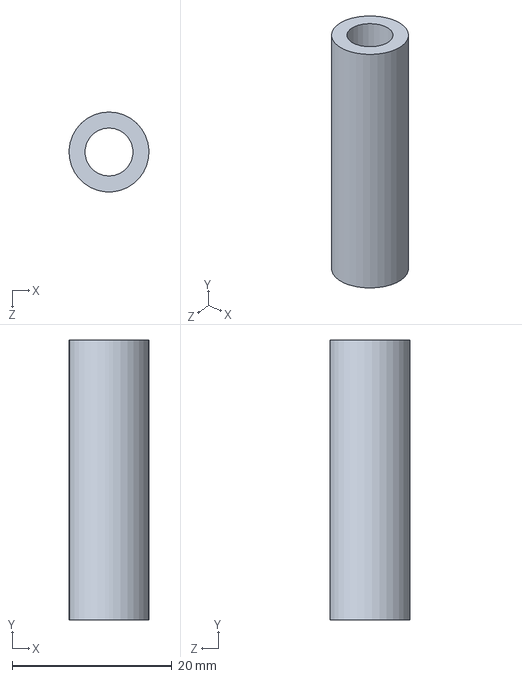
[picture p80: CAD file, 2024-09-10]
1_Mechanic/Alexbotmini_V1.0/upperbody(without yaw)/M6螺柱35.SLDPRT
9.99 x 35.0 x 10.0 mm
