Alexhuge1/fftai_alexbotmini/1_Mechanic/Alexbotmini_V1.0/wholebody/M10导向轴.SLDPRT

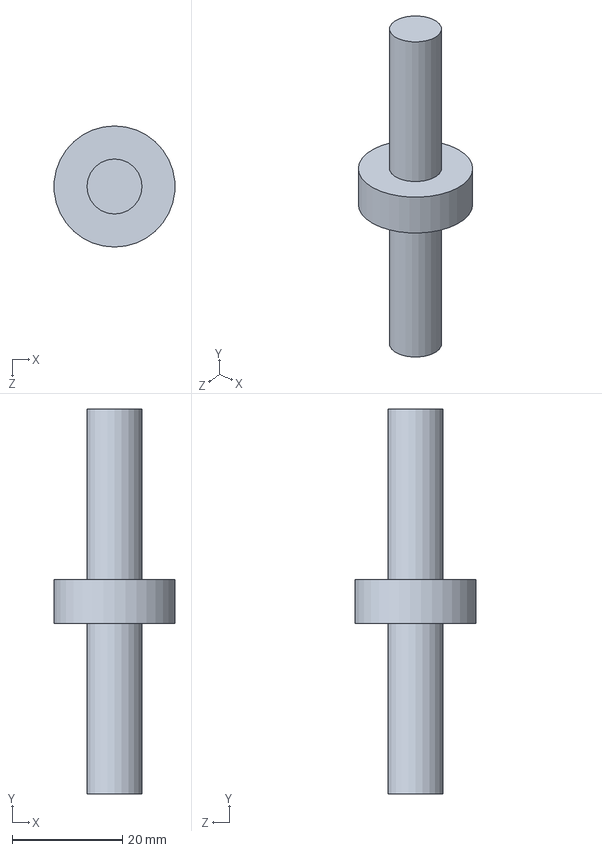
[picture p81: CAD file, 2024-09-24]
1_Mechanic/Alexbotmini_V1.0/wholebody/M10导向轴.SLDPRT
21.9 x 69.9 x 22.0 mm
