Alexhuge1/fftai_alexbotmini/1_Mechanic/Alexbotmini_V1.0/upperbody(without yaw)/battery.SLDPRT

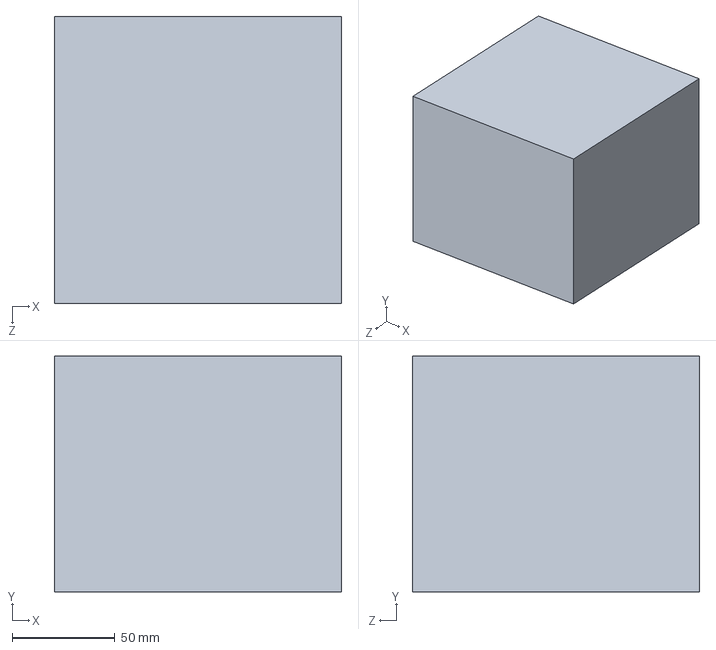
[picture p83: CAD file, 2024-09-09]
1_Mechanic/Alexbotmini_V1.0/upperbody(without yaw)/battery.SLDPRT
140.0 x 115.0 x 140.0 mm
