Alexhuge1/fftai_alexbotmini/1_Mechanic/Alexbotmini_V1.0/wholebody/back.SLDPRT

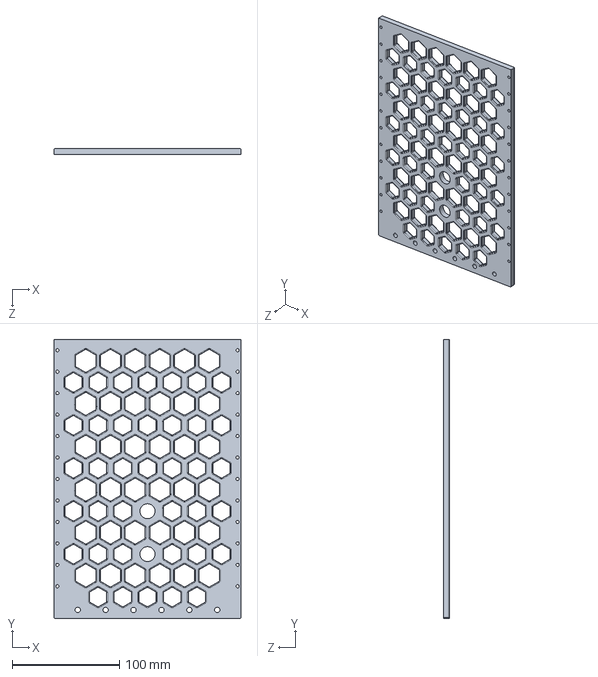
[picture p84: CAD file, 2024-09-12]
1_Mechanic/Alexbotmini_V1.0/wholebody/back.SLDPRT
174.0 x 260.0 x 6.00 mm
