Alexhuge1/fftai_alexbotmini/3_Walk and trot/humanoid-gym/resources/robots/XBot/meshes/left_hand_index_bend_link.STL

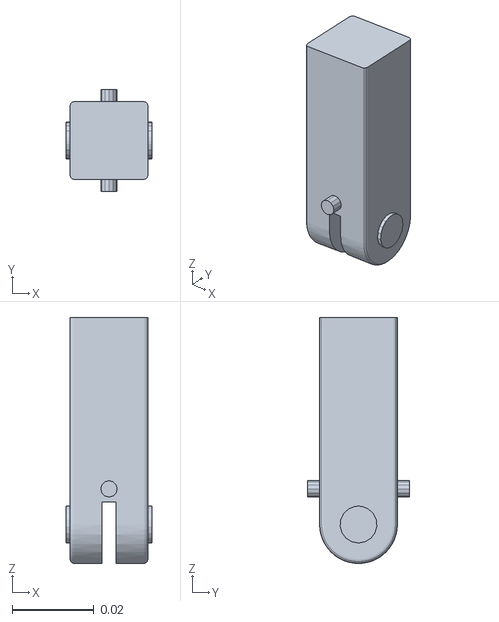
[picture p85: CAD file, 2024-08-29]
3_Walk and trot/humanoid-gym/resources/robots/XBot/meshes/left_hand_index_bend_link.STL
0.021 x 0.025 x 0.06
