Alexhuge1/fftai_alexbotmini/1_Mechanic/Alexbotmini_V1.0/upperbody(without yaw)/top.SLDPRT

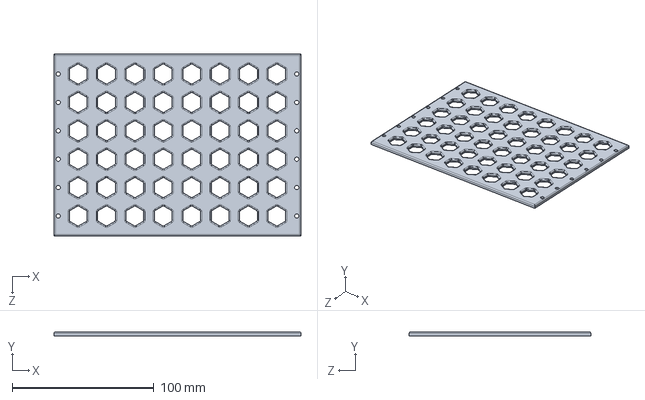
[picture p87: CAD file, 2024-09-09]
1_Mechanic/Alexbotmini_V1.0/upperbody(without yaw)/top.SLDPRT
174.0 x 3.00 x 128.0 mm
