Alexhuge1/fftai_alexbotmini/3_Walk and trot/humanoid-gym/resources/robots/XBot/meshes/right_hand_mid_link1.STL

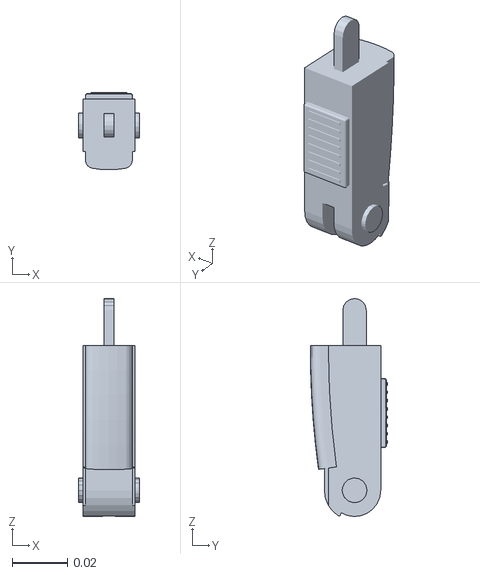
[picture p88: CAD file, 2024-08-29]
3_Walk and trot/humanoid-gym/resources/robots/XBot/meshes/right_hand_mid_link1.STL
0.022 x 0.028 x 0.079
