Alexhuge1/fftai_alexbotmini/3_Walk and trot/humanoid-gym/resources/robots/XBot/urdf/left_leg_yaw_link.STL

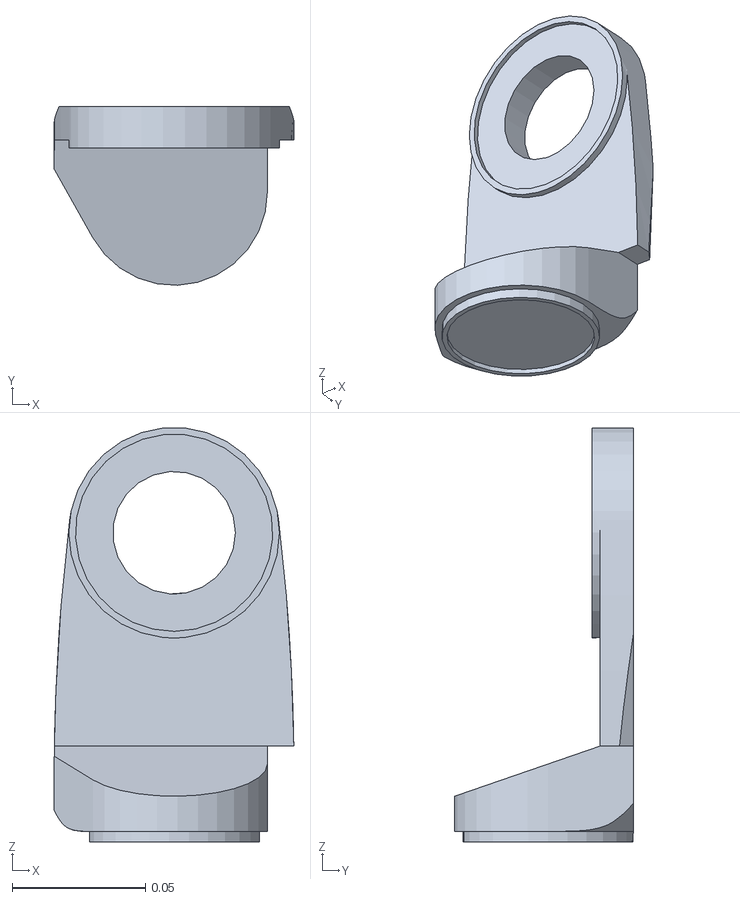
[picture p89: CAD file, 2024-08-29]
3_Walk and trot/humanoid-gym/resources/robots/XBot/urdf/left_leg_yaw_link.STL
0.0899 x 0.067 x 0.155
