Alexhuge1/fftai_alexbotmini/1_Mechanic/alexbotmini_urdf/alexbotmini/meshes/rightlink5.STL

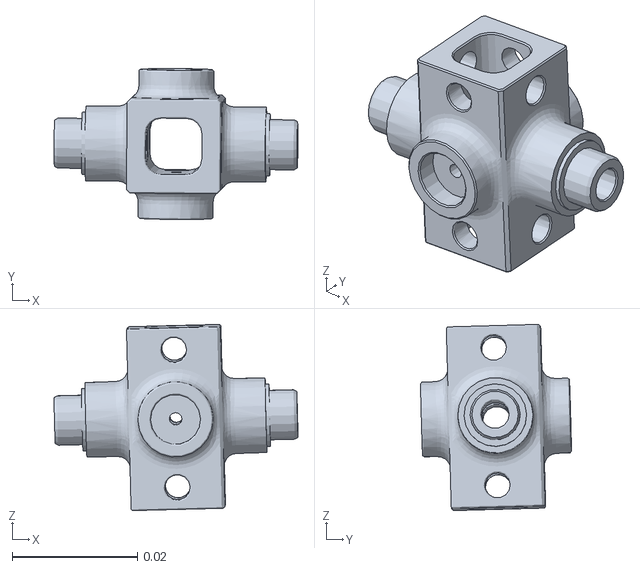
[picture p90: CAD file, 2024-08-29]
1_Mechanic/alexbotmini_urdf/alexbotmini/meshes/rightlink5.STL
0.039 x 0.0241 x 0.0297
