Alexhuge1/fftai_alexbotmini/1_Mechanic/Alexbotmini_V1.0/upperbody(without yaw)/M8螺柱.SLDPRT

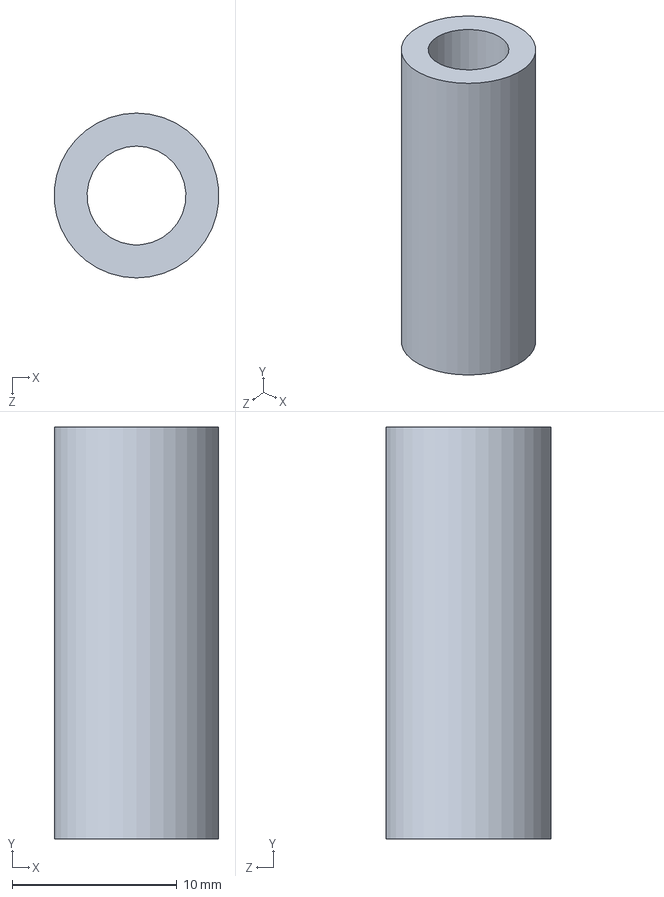
[picture p91: CAD file, 2024-09-09]
1_Mechanic/Alexbotmini_V1.0/upperbody(without yaw)/M8螺柱.SLDPRT
9.97 x 25.0 x 10.0 mm
