Alexhuge1/fftai_alexbotmini/3_Walk and trot/humanoid-gym/resources/robots/XBot/meshes/waist_yaw_link.STL

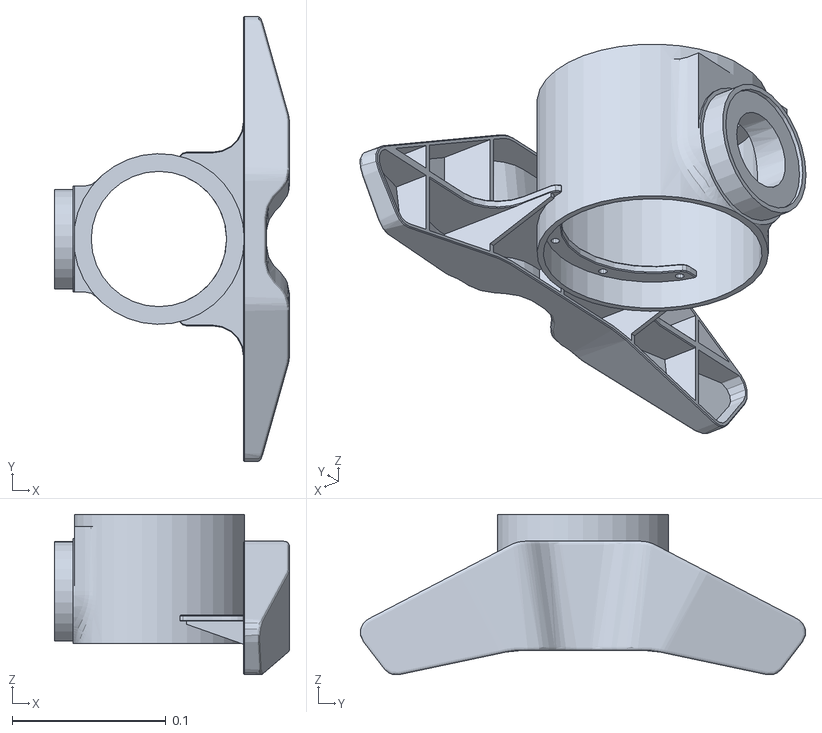
[picture p92: CAD file, 2024-08-29]
3_Walk and trot/humanoid-gym/resources/robots/XBot/meshes/waist_yaw_link.STL
0.153 x 0.289 x 0.104
