Alexhuge1/fftai_alexbotmini/3_Walk and trot/humanoid-gym/resources/robots/XBot/urdf/left_knee_linkage_link.STL

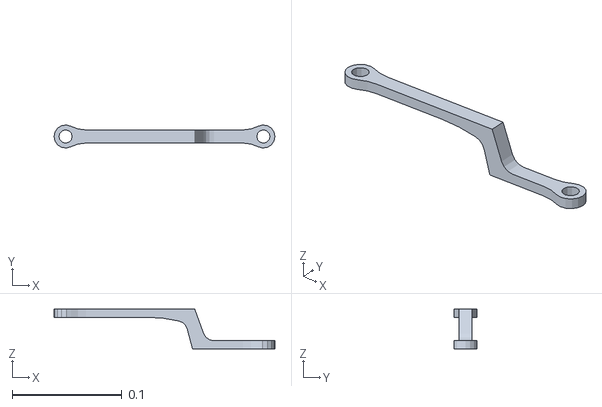
[picture p93: CAD file, 2024-08-29]
3_Walk and trot/humanoid-gym/resources/robots/XBot/urdf/left_knee_linkage_link.STL
0.201 x 0.021 x 0.0363
