Alexhuge1/fftai_alexbotmini/3_Walk and trot/humanoid-gym/resources/robots/XBot/meshes/right_ankle_pitch_linkage2_link.STL

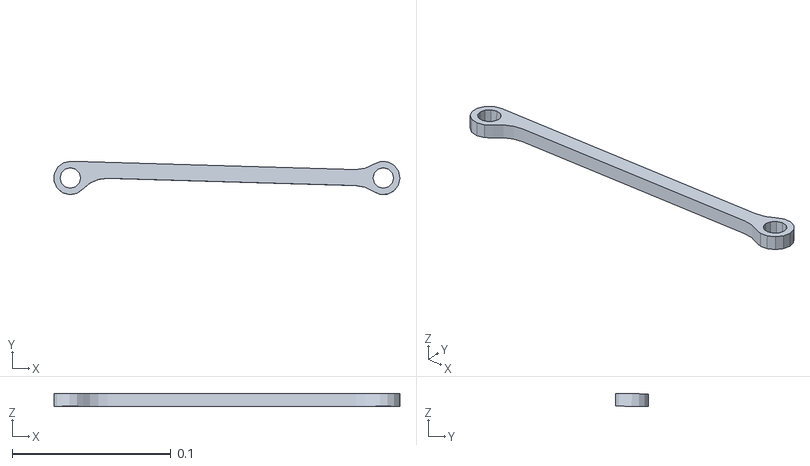
[picture p94: CAD file, 2024-08-29]
3_Walk and trot/humanoid-gym/resources/robots/XBot/meshes/right_ankle_pitch_linkage2_link.STL
0.218 x 0.0211 x 0.00829
