Alexhuge1/fftai_alexbotmini/3_Walk and trot/humanoid-gym/resources/robots/XBot/urdf/left_ankle_pitch_link.STL

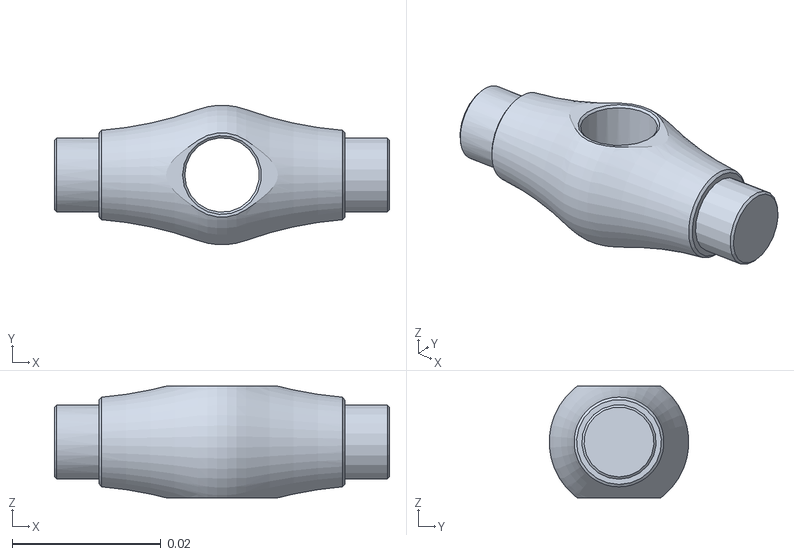
[picture p95: CAD file, 2024-08-29]
3_Walk and trot/humanoid-gym/resources/robots/XBot/urdf/left_ankle_pitch_link.STL
0.045 x 0.0187 x 0.015
