Alexhuge1/fftai_alexbotmini/3_Walk and trot/humanoid-gym/resources/robots/XBot/urdf/left_knee_link.STL

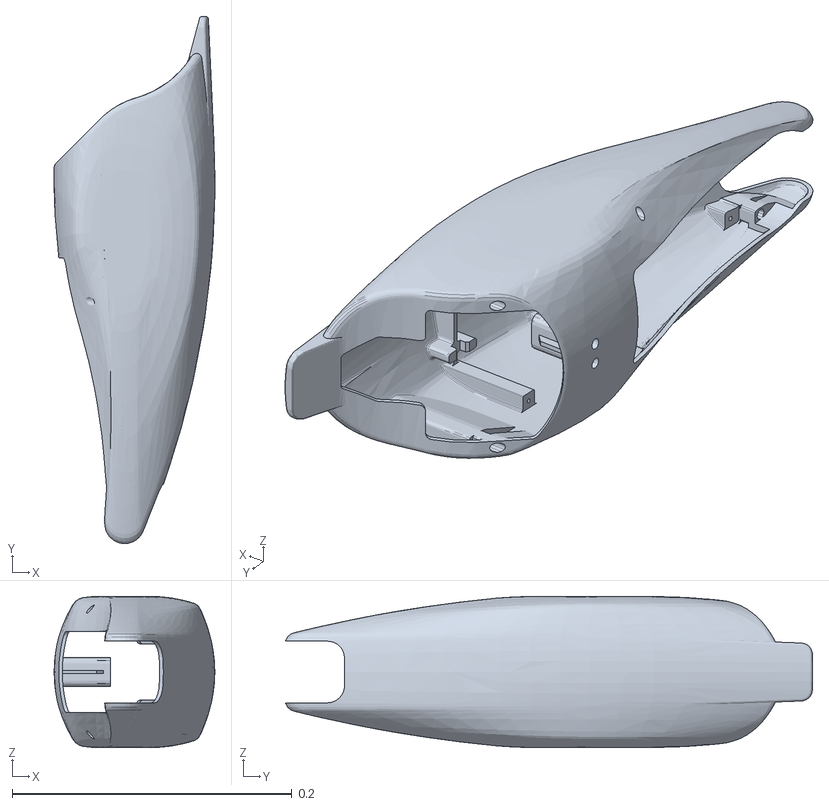
[picture p96: CAD file, 2024-08-29]
3_Walk and trot/humanoid-gym/resources/robots/XBot/urdf/left_knee_link.STL
0.115 x 0.377 x 0.108
