Alexhuge1/fftai_alexbotmini/3_Walk and trot/humanoid-gym/resources/robots/XBot/meshes/right_ankle_pitch_link.STL

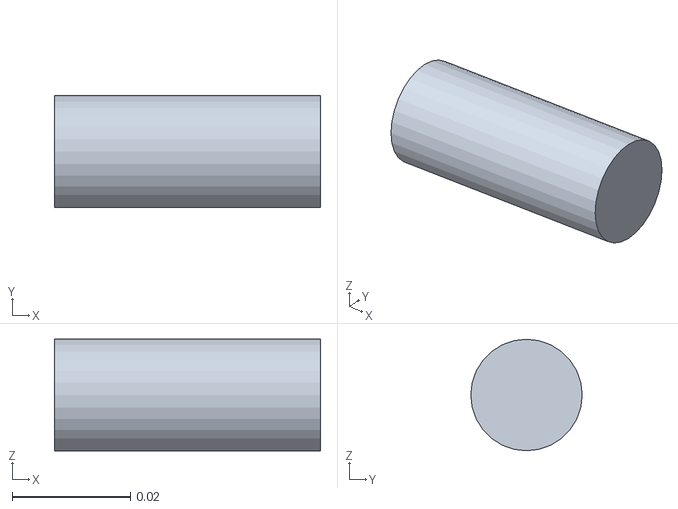
[picture p97: CAD file, 2024-08-29]
3_Walk and trot/humanoid-gym/resources/robots/XBot/meshes/right_ankle_pitch_link.STL
0.045 x 0.0189 x 0.0189
