Alexhuge1/fftai_alexbotmini/3_Walk and trot/humanoid-gym/resources/robots/XBot/urdf/waist_roll_link.STL

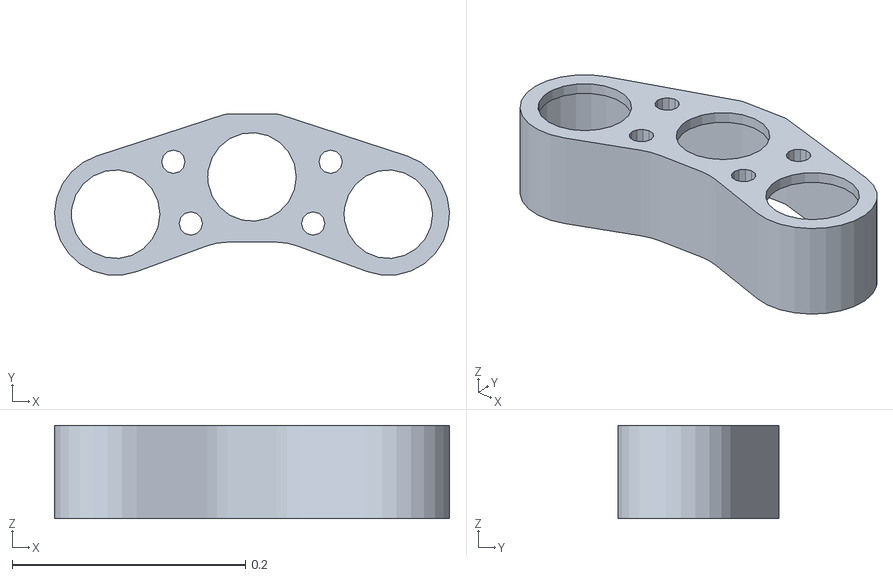
[picture p99: CAD file, 2024-08-29]
3_Walk and trot/humanoid-gym/resources/robots/XBot/urdf/waist_roll_link.STL
0.339 x 0.138 x 0.08
