Alexhuge1/fftai_alexbotmini/1_Mechanic/Alexbotmini_V1.0/wholebody/镜向碳纤维板_copy.SLDPRT

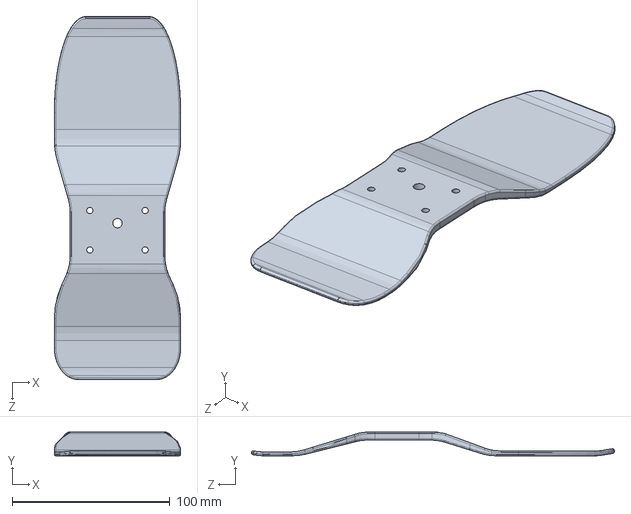
[picture p100: CAD file, 2024-09-10]
1_Mechanic/Alexbotmini_V1.0/wholebody/镜向碳纤维板_copy.SLDPRT
80.0 x 15.0 x 229.8 mm
