Alexhuge1/fftai_alexbotmini/3_Walk and trot/humanoid-gym/resources/robots/XBot/urdf/neck_yaw_link.STL

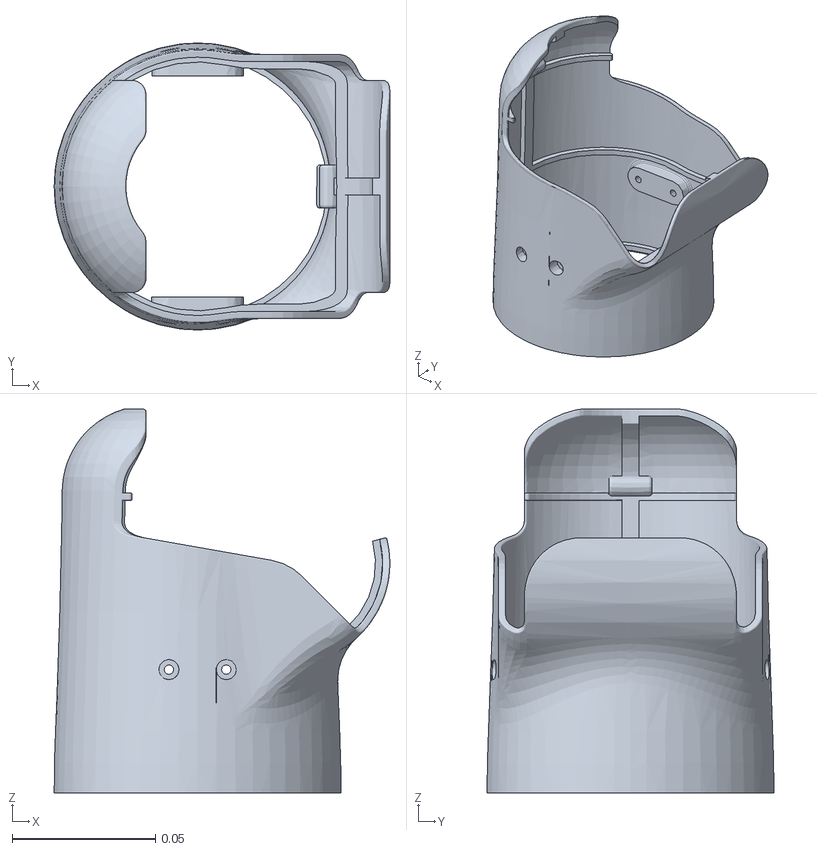
[picture p101: CAD file, 2024-08-29]
3_Walk and trot/humanoid-gym/resources/robots/XBot/urdf/neck_yaw_link.STL
0.117 x 0.1 x 0.134
