Alexhuge1/fftai_alexbotmini/3_Walk and trot/humanoid-gym/resources/robots/XBot/meshes/right_arm_yaw_link.STL

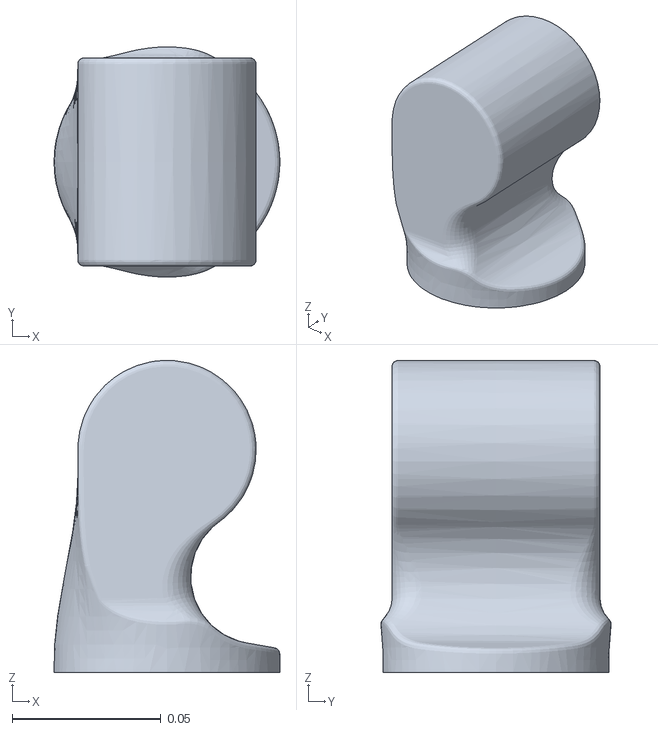
[picture p102: CAD file, 2024-08-29]
3_Walk and trot/humanoid-gym/resources/robots/XBot/meshes/right_arm_yaw_link.STL
0.076 x 0.0774 x 0.105
