Alexhuge1/fftai_alexbotmini/3_Walk and trot/humanoid-gym/resources/robots/XBot/urdf/right_hand_thumb_rota_link1.STL

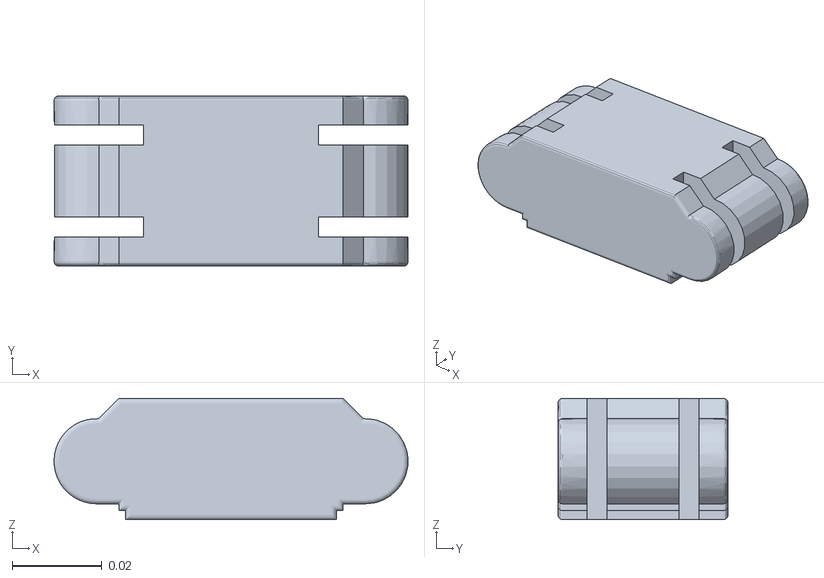
[picture p103: CAD file, 2024-08-29]
3_Walk and trot/humanoid-gym/resources/robots/XBot/urdf/right_hand_thumb_rota_link1.STL
0.079 x 0.038 x 0.027
