Alexhuge1/fftai_alexbotmini/1_Mechanic/Alexbotmini_V1.0/wholebody/GR1-07-2-034-G,脚板十字座_copy.SLDPRT

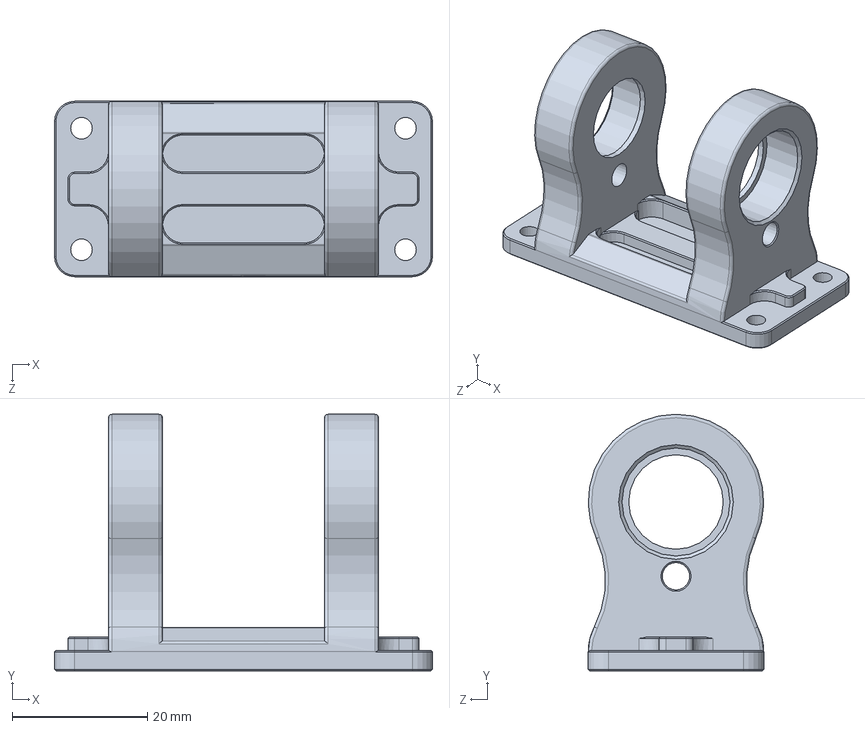
[picture p104: CAD file, 2024-09-06]
1_Mechanic/Alexbotmini_V1.0/wholebody/GR1-07-2-034-G,脚板十字座_copy.SLDPRT
56.0 x 38.0 x 26.0 mm
