Alexhuge1/fftai_alexbotmini/3_Walk and trot/humanoid-gym/resources/robots/XBot/urdf/left_hand_link.STL

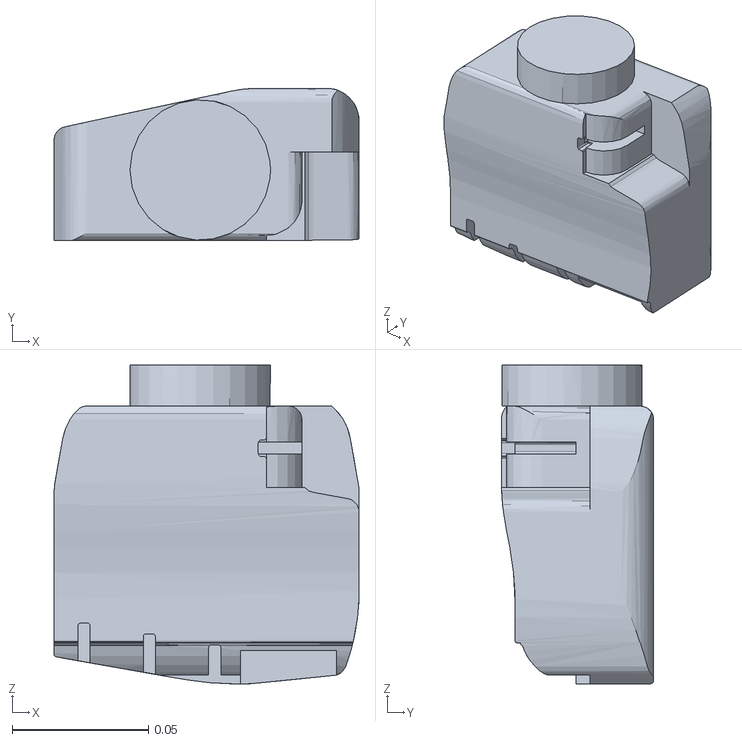
[picture p105: CAD file, 2024-08-29]
3_Walk and trot/humanoid-gym/resources/robots/XBot/urdf/left_hand_link.STL
0.112 x 0.056 x 0.117
