Alexhuge1/fftai_alexbotmini/1_Mechanic/Alexbotmini_V1.0/wholebody/GR1-07-2-059-G,脚板连杆座-1_copy.SLDPRT

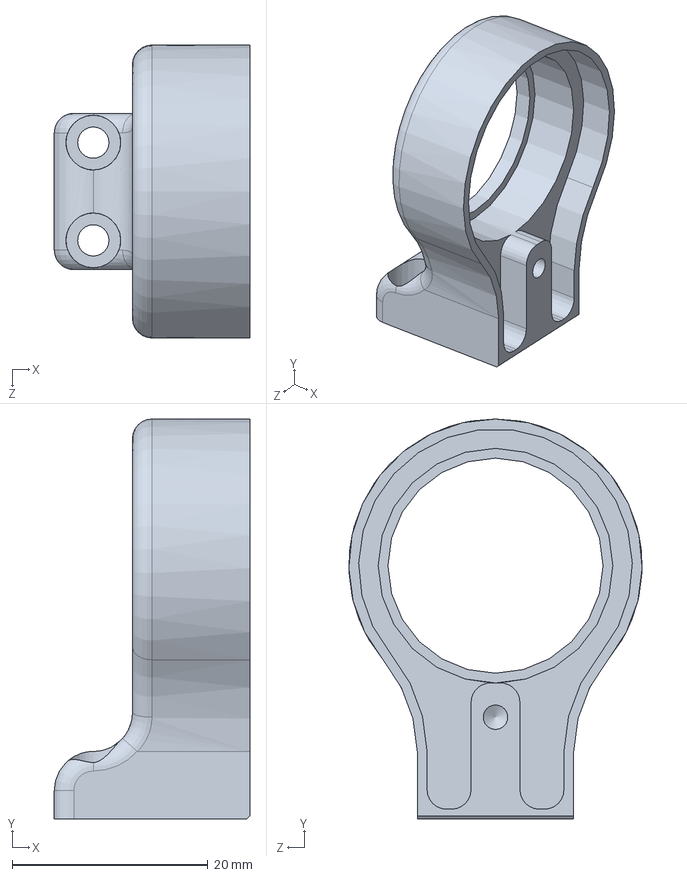
[picture p106: CAD file, 2024-09-06]
1_Mechanic/Alexbotmini_V1.0/wholebody/GR1-07-2-059-G,脚板连杆座-1_copy.SLDPRT
20.0 x 40.9 x 30.0 mm
