Alexhuge1/fftai_alexbotmini/1_Mechanic/Alexbotmini_V1.0/wholebody/SC-BEAR-628-8,深沟球轴承628-8_copy.SLDPRT

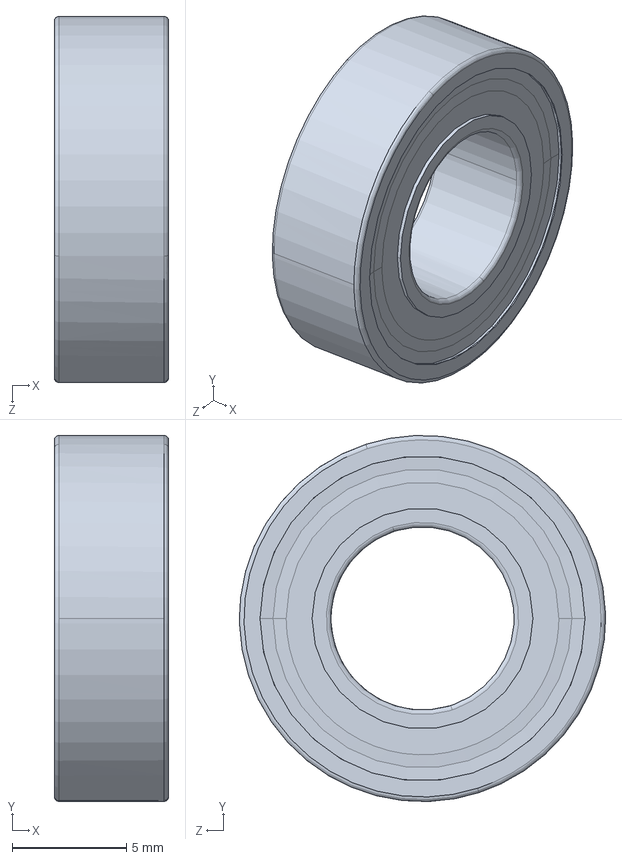
[picture p107: CAD file, 2024-09-06]
1_Mechanic/Alexbotmini_V1.0/wholebody/SC-BEAR-628-8,深沟球轴承628-8_copy.SLDPRT
5.00 x 16.0 x 16.0 mm
