Alexhuge1/fftai_alexbotmini/3_Walk and trot/humanoid-gym/resources/robots/XBot/urdf/left_shoulder_roll_link.STL

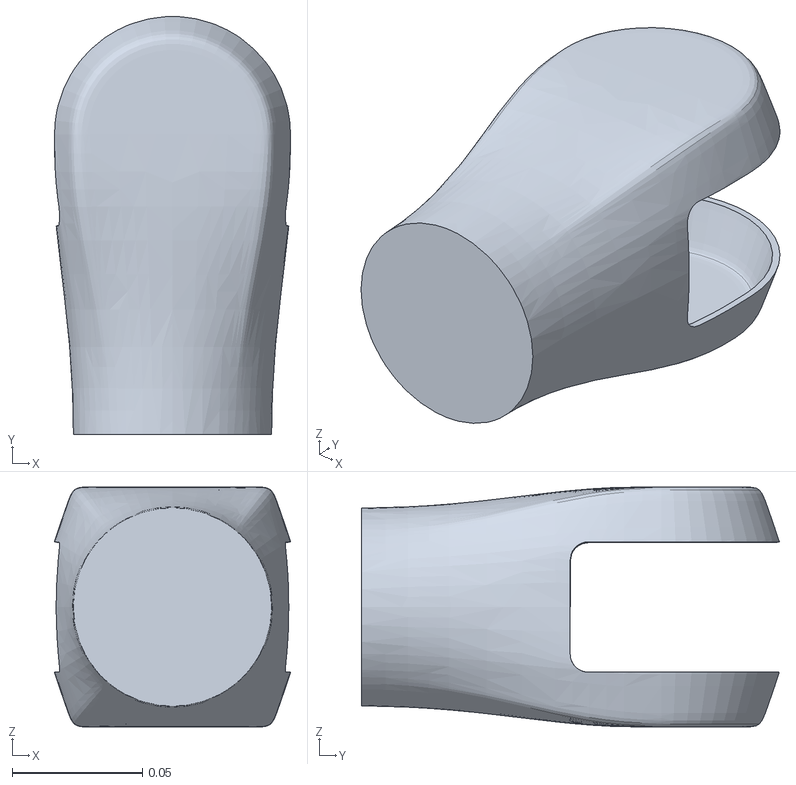
[picture p108: CAD file, 2024-08-29]
3_Walk and trot/humanoid-gym/resources/robots/XBot/urdf/left_shoulder_roll_link.STL
0.0905 x 0.16 x 0.092
