Alexhuge1/fftai_alexbotmini/1_Mechanic/Alexbotmini_V1.0/wholebody/SC-BEAR-6802-ZZ,深沟球轴承6802_copy.SLDPRT

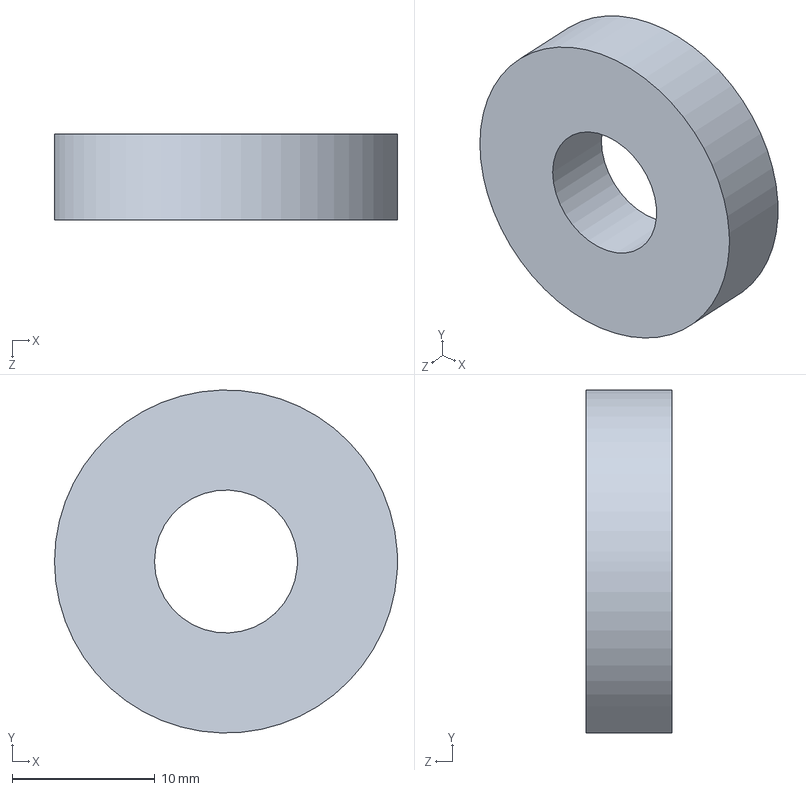
[picture p109: CAD file, 2024-09-06]
1_Mechanic/Alexbotmini_V1.0/wholebody/SC-BEAR-6802-ZZ,深沟球轴承6802_copy.SLDPRT
24.0 x 24.0 x 6.00 mm
