Alexhuge1/fftai_alexbotmini/1_Mechanic/Alexbotmini_V1.0/wholebody/球轴承.SLDPRT

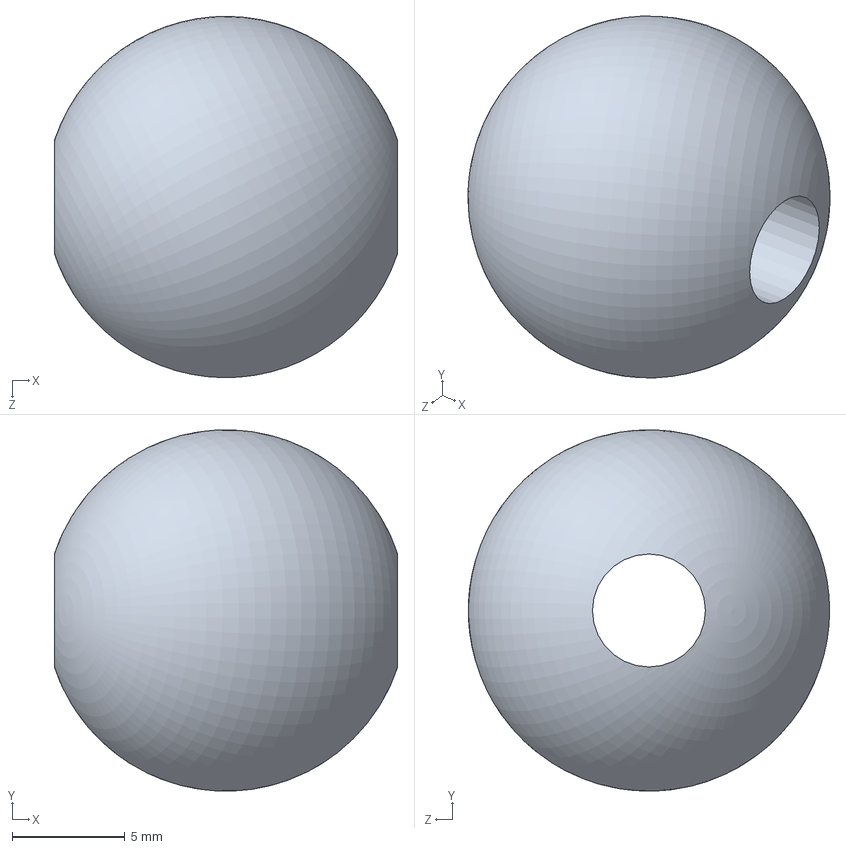
[picture p110: CAD file, 2024-09-06]
1_Mechanic/Alexbotmini_V1.0/wholebody/球轴承.SLDPRT
15.2 x 16.0 x 16.0 mm
