Alexhuge1/fftai_alexbotmini/3_Walk and trot/humanoid-gym/resources/robots/XBot/meshes/right_hand_thumb_rota_link2.STL

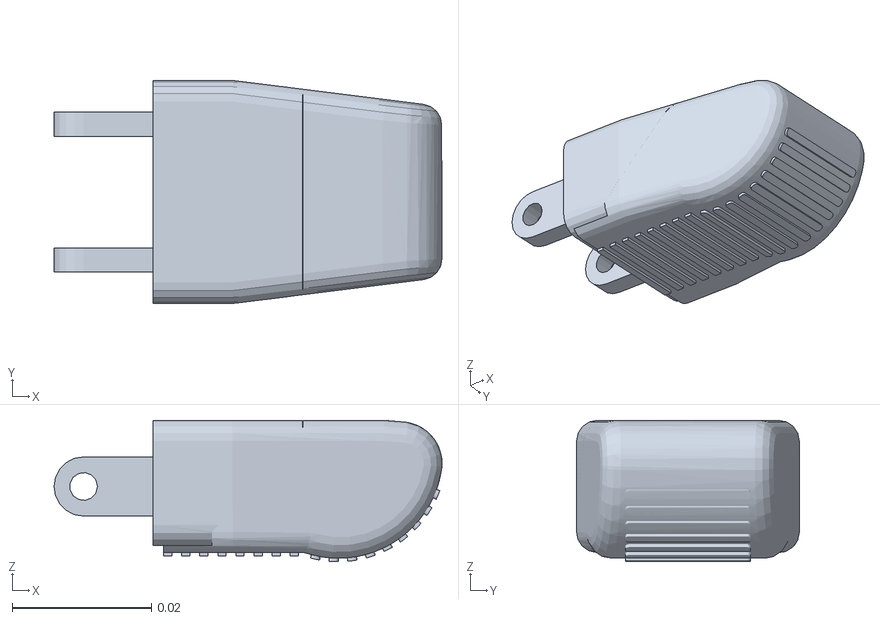
[picture p111: CAD file, 2024-08-29]
3_Walk and trot/humanoid-gym/resources/robots/XBot/meshes/right_hand_thumb_rota_link2.STL
0.0557 x 0.032 x 0.0203
