Alexhuge1/fftai_alexbotmini/3_Walk and trot/humanoid-gym/resources/robots/XBot/meshes/left_elbow_yaw_link.STL

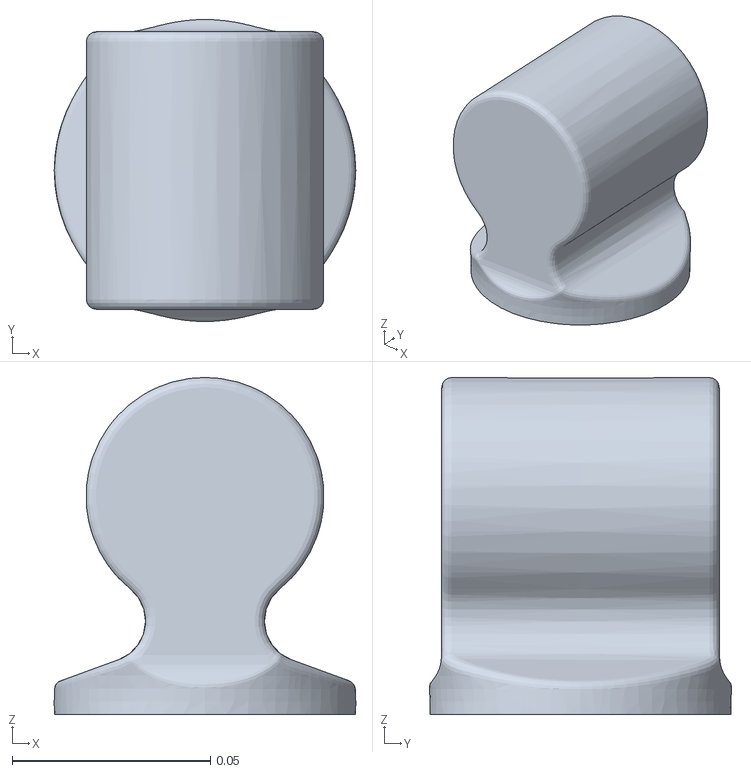
[picture p112: CAD file, 2024-08-29]
3_Walk and trot/humanoid-gym/resources/robots/XBot/meshes/left_elbow_yaw_link.STL
0.0761 x 0.0762 x 0.085
