Alexhuge1/fftai_alexbotmini/1_Mechanic/Alexbotmini_V1.0/wholebody/GR1-07-2-030,踝十字轴_copy.SLDPRT

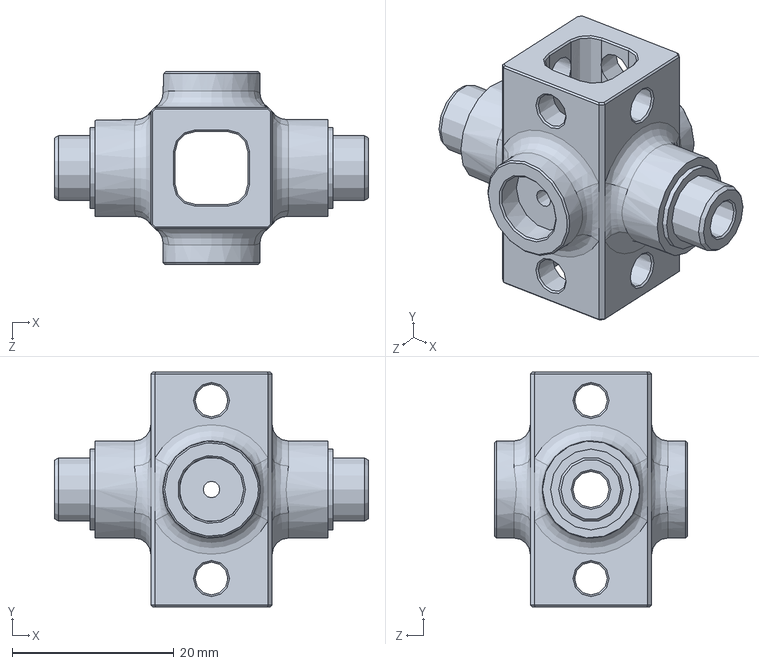
[picture p113: CAD file, 2024-09-06]
1_Mechanic/Alexbotmini_V1.0/wholebody/GR1-07-2-030,踝十字轴_copy.SLDPRT
38.8 x 29.0 x 23.8 mm
