Alexhuge1/fftai_alexbotmini/3_Walk and trot/humanoid-gym/resources/robots/XBot/urdf/left_shoulder_pitch_link.STL

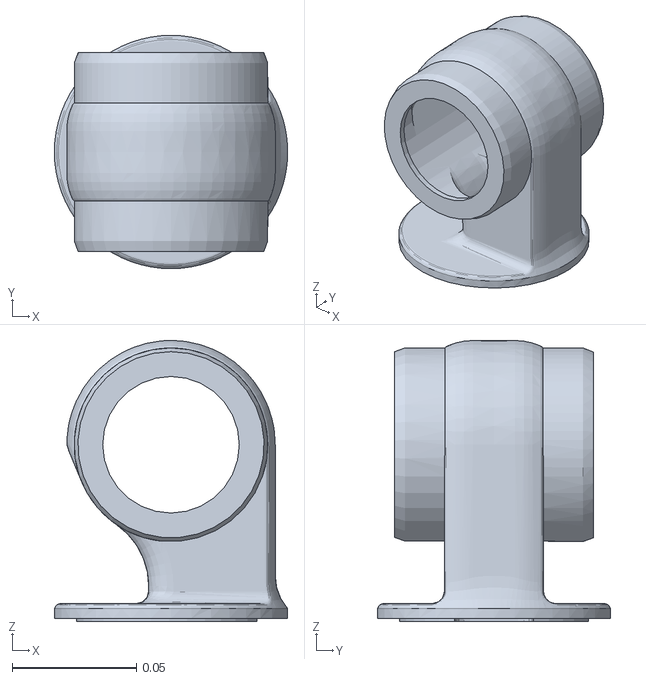
[picture p114: CAD file, 2024-08-29]
3_Walk and trot/humanoid-gym/resources/robots/XBot/urdf/left_shoulder_pitch_link.STL
0.094 x 0.094 x 0.113
