Alexhuge1/fftai_alexbotmini/1_Mechanic/Alexbotmini_V1.0/wholebody/M5球头.SLDPRT

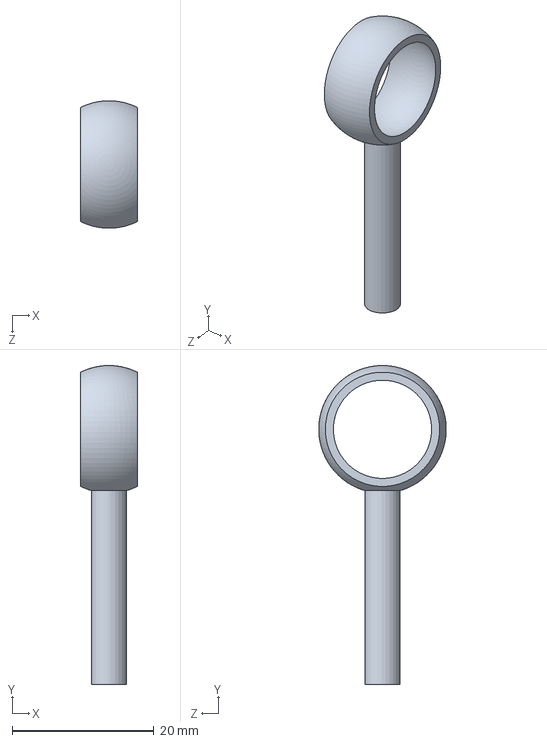
[picture p115: CAD file, 2024-09-06]
1_Mechanic/Alexbotmini_V1.0/wholebody/M5球头.SLDPRT
8.00 x 45.0 x 18.0 mm
