Alexhuge1/fftai_alexbotmini/1_Mechanic/Alexbotmini_V1.0/wholebody/GR1-07-2-049-G,脚板转接件_copy.SLDPRT

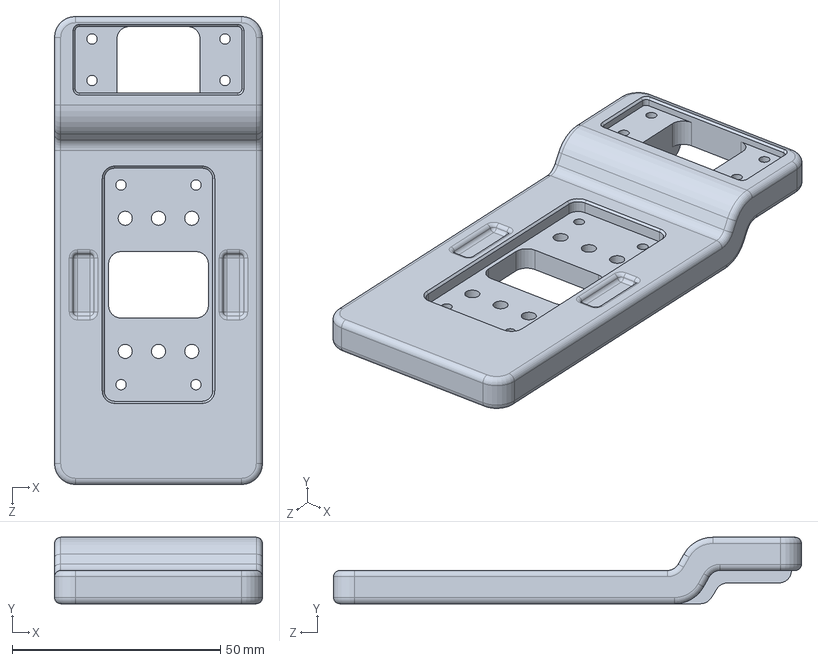
[picture p116: CAD file, 2024-09-06]
1_Mechanic/Alexbotmini_V1.0/wholebody/GR1-07-2-049-G,脚板转接件_copy.SLDPRT
50.0 x 16.0 x 112.5 mm
