Alexhuge1/fftai_alexbotmini/1_Mechanic/Alexbotmini_V1.0/wholebody/GR1-07-2-033,关节延长轴_copy.SLDPRT

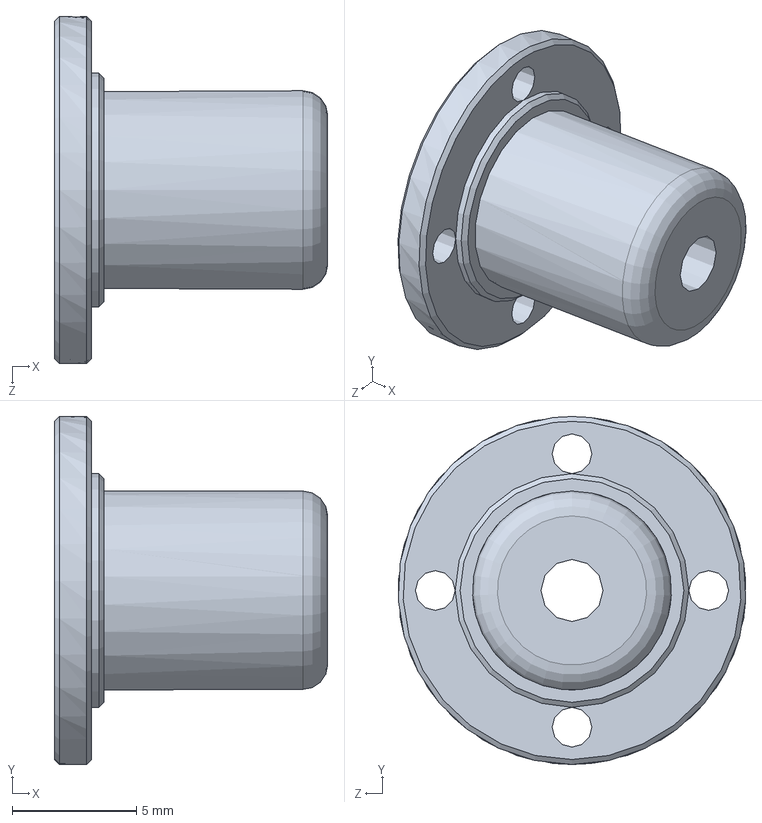
[picture p117: CAD file, 2024-09-06]
1_Mechanic/Alexbotmini_V1.0/wholebody/GR1-07-2-033,关节延长轴_copy.SLDPRT
11.0 x 14.0 x 14.0 mm
