Alexhuge1/fftai_alexbotmini/1_Mechanic/Alexbotmini_V1.0/wholebody/M10导向轴_80.SLDPRT

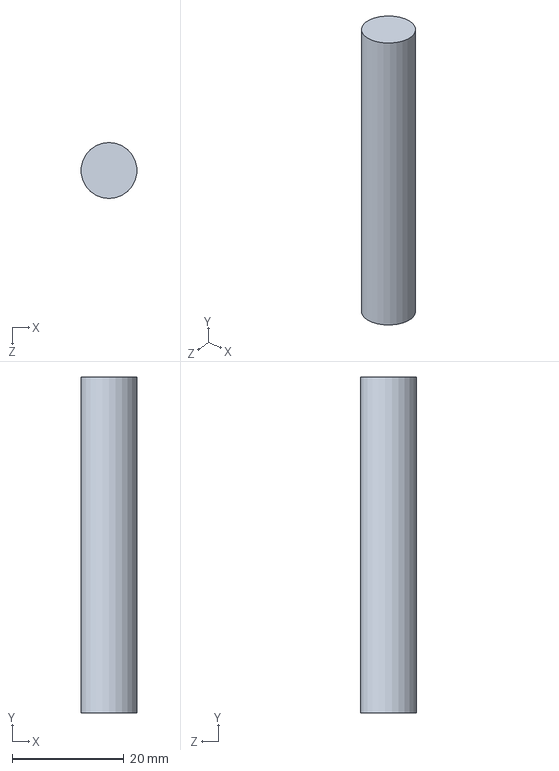
[picture p118: CAD file, 2024-08-29]
1_Mechanic/Alexbotmini_V1.0/wholebody/M10导向轴_80.SLDPRT
9.93 x 60.0 x 10.0 mm
