Alexhuge1/fftai_alexbotmini/1_Mechanic/Alexbotmini_V1.0/wholebody/M10导向轴_140.SLDPRT

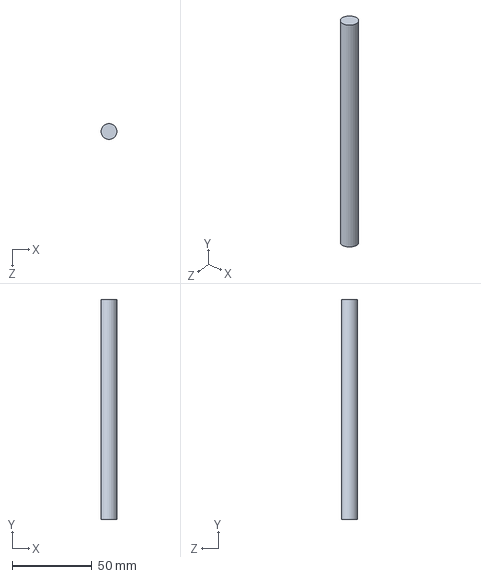
[picture p119: CAD file, 2024-08-29]
1_Mechanic/Alexbotmini_V1.0/wholebody/M10导向轴_140.SLDPRT
10.0 x 138.0 x 10.0 mm
