Alexhuge1/fftai_alexbotmini/1_Mechanic/Alexbotmini_V1.0/wholebody/GR1-06-2-048,右脚包胶足撑_copy.SLDASM

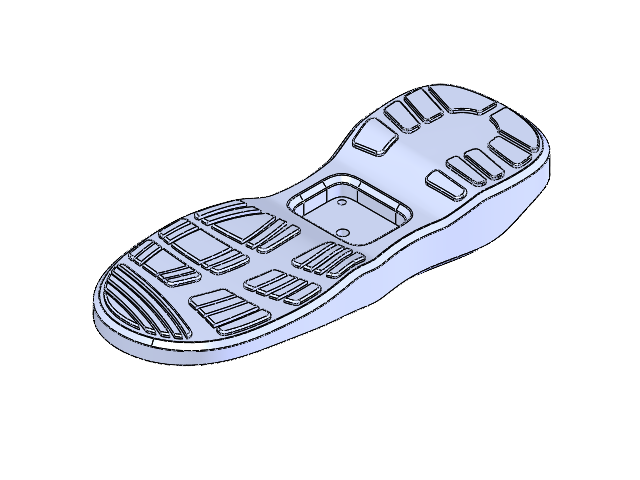
[picture p120: CAD file, 2024-09-10]
1_Mechanic/Alexbotmini_V1.0/wholebody/GR1-06-2-048,右脚包胶足撑_copy.SLDASM
镜向碳纤维板_copy
镜向硅胶脚0418_copy
