Alexhuge1/fftai_alexbotmini/1_Mechanic/Alexbotmini_V1.0/wholebody/GR1-07-2-048,左脚包胶足撑_copy.SLDASM

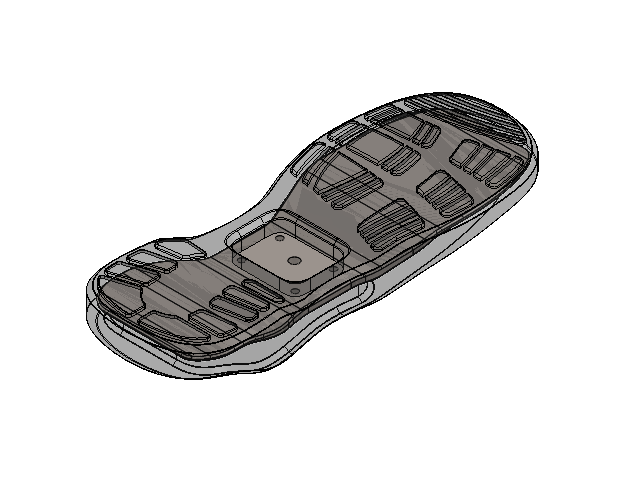
[picture p121: CAD file, 2024-09-10]
1_Mechanic/Alexbotmini_V1.0/wholebody/GR1-07-2-048,左脚包胶足撑_copy.SLDASM
碳纤维板_copy
硅胶脚0418_copy
