Alexhuge1/fftai_alexbotmini/(list of files, cad)

Other CAD files:
1_Mechanic/Alexbotmini_V1.0/for_cnc(unchanged)/step/crotch.step
1_Mechanic/Alexbotmini_V1.0/for_cnc(unchanged)/3D/front.SLDPRT
1_Mechanic/Alexbotmini_V1.0/upperbody(without yaw)/crotch.SLDPRT
1_Mechanic/Alexbotmini_V1.0/upperbody(without yaw)/电路模型/imu/HI14_M12_Angled(弯头).STEP
1_Mechanic/Alexbotmini_V1.0/wholebody/crotch.SLDPRT
1_Mechanic/Alexbotmini_V1.0/CNCchange/thigh2.STEP
3_Walk and trot/humanoid-gym/resources/robots/XBot/urdf/right_ankle_pitch_motor2_link.STL
1_Mechanic/Alexbotmini_V1.0/upperbody(without yaw)/back.SLDPRT
1_Mechanic/Alexbotmini_V1.0/for_cnc(unchanged)/3D/left.SLDPRT
1_Mechanic/Alexbotmini_V1.0/wholebody/left.SLDPRT
1_Mechanic/Alexbotmini_V1.0/wholebody/thigh1.SLDPRT
3_Walk and trot/humanoid-gym/resources/robots/XBot/meshes/right_ankle_pitch_motor1_link.STL
3_Walk and trot/humanoid-gym/resources/robots/XBot/urdf/left_hand_thumb_bend_link.STL
3_Walk and trot/humanoid-gym/resources/robots/XBot/urdf/right_hand_index_tip.STL
1_Mechanic/Alexbotmini_V1.0/for_cnc(unchanged)/step/thigh1.step
1_Mechanic/Alexbotmini_V1.0/for_cnc(unchanged)/step/fsa60_43e_output.step
1_Mechanic/alexbotmini_urdf/alexbotmini/meshes/rightlink1.STL
3_Walk and trot/humanoid-gym/resources/robots/XBot/meshes/right_ankle_pitch_motor2_link.STL
3_Walk and trot/humanoid-gym/resources/robots/XBot/meshes/left_hand_ring_link1.STL
3_Walk and trot/humanoid-gym/resources/robots/XBot/urdf/right_hand_pinky_tip.STL
1_Mechanic/Alexbotmini_V1.0/wholebody/imu.SLDPRT
3_Walk and trot/humanoid-gym/resources/robots/XBot/meshes/left_hand_mid_link1.STL
3_Walk and trot/humanoid-gym/resources/robots/XBot/urdf/right_hand_index_bend_link.STL
3_Walk and trot/humanoid-gym/resources/robots/XBot/meshes/right_hand_pinky_link1.STL
1_Mechanic/Alexbotmini_V1.0/wholebody/HI14_M12_Angled(弯头).STEP
3_Walk and trot/humanoid-gym/resources/robots/XBot/urdf/left_hand_ring_link1.STL
3_Walk and trot/humanoid-gym/resources/robots/XBot/meshes/left_hand_pinky_tip.STL
3_Walk and trot/humanoid-gym/resources/robots/XBot/urdf/left_ankle_pitch_linkage2_link.STL
3_Walk and trot/humanoid-gym/resources/robots/XBot/meshes/left_knee_motor_link.STL
3_Walk and trot/humanoid-gym/resources/robots/XBot/urdf/right_leg_roll_link.STL
3_Walk and trot/humanoid-gym/resources/robots/XBot/meshes/left_hand_index_tip.STL
3_Walk and trot/humanoid-gym/resources/robots/XBot/meshes/right_hand_mid_tip.STL
3_Walk and trot/humanoid-gym/resources/robots/XBot/urdf/right_hand_index_rota_link1.STL
1_Mechanic/Alexbotmini_V1.0/wholebody/calf1.SLDPRT
1_Mechanic/Alexbotmini_V1.0/wholebody/GR1-07-2-017-G,脚板连杆座_copy.SLDPRT
3_Walk and trot/humanoid-gym/resources/robots/XBot/meshes/right_ankle_roll_link.STL
1_Mechanic/Alexbotmini_V1.0/wholebody/碳纤维板_copy.SLDPRT
3_Walk and trot/humanoid-gym/resources/robots/XBot/meshes/right_shoulder_pitch_link.STL
3_Walk and trot/humanoid-gym/resources/robots/XBot/urdf/left_leg_pitch_link.STL
3_Walk and trot/humanoid-gym/resources/robots/XBot/urdf/left_arm_yaw_link.STL
3_Walk and trot/humanoid-gym/resources/robots/XBot/meshes/left_ankle_pitch_linkage2_link.STL
3_Walk and trot/humanoid-gym/resources/robots/XBot/meshes/right_hand_thumb_rota_tip.STL
3_Walk and trot/humanoid-gym/resources/robots/XBot/urdf/right_hand_link.STL
3_Walk and trot/humanoid-gym/resources/robots/XBot/meshes/right_hand_ring_link2.STL
3_Walk and trot/humanoid-gym/resources/robots/XBot/urdf/right_knee_link.STL
3_Walk and trot/humanoid-gym/resources/robots/XBot/meshes/left_hand_mid_link2.STL
1_Mechanic/Alexbotmini_V1.0/CNCchange/crotch.SLDPRT
1_Mechanic/Alexbotmini_V1.0/CNCchange/fsa60_43e_output.SLDPRT
1_Mechanic/Alexbotmini_V1.0/CNCchange/thigh1.SLDPRT
1_Mechanic/Alexbotmini_V1.0/CNCchange/thigh2.SLDPRT
1_Mechanic/Alexbotmini_V1.0/for_cnc(unchanged)/2D/back.SLDDRW
1_Mechanic/Alexbotmini_V1.0/for_cnc(unchanged)/2D/calf1 - 副本.SLDDRW
1_Mechanic/Alexbotmini_V1.0/for_cnc(unchanged)/2D/calf1.SLDDRW
1_Mechanic/Alexbotmini_V1.0/for_cnc(unchanged)/2D/crotch.SLDDRW
1_Mechanic/Alexbotmini_V1.0/for_cnc(unchanged)/2D/ctrlbox.SLDDRW
1_Mechanic/Alexbotmini_V1.0/for_cnc(unchanged)/2D/front.SLDDRW
1_Mechanic/Alexbotmini_V1.0/for_cnc(unchanged)/2D/fsa45_30_output.SLDDRW
1_Mechanic/Alexbotmini_V1.0/for_cnc(unchanged)/2D/fsa60_43e_output.SLDDRW
1_Mechanic/Alexbotmini_V1.0/for_cnc(unchanged)/2D/fsa80_29e_output.SLDDRW
1_Mechanic/Alexbotmini_V1.0/for_cnc(unchanged)/2D/fsa80_29e_output_long.SLDDRW
1_Mechanic/Alexbotmini_V1.0/for_cnc(unchanged)/2D/knee.SLDDRW
1_Mechanic/Alexbotmini_V1.0/for_cnc(unchanged)/2D/left.SLDDRW
1_Mechanic/Alexbotmini_V1.0/for_cnc(unchanged)/2D/right.SLDDRW
1_Mechanic/Alexbotmini_V1.0/for_cnc(unchanged)/2D/thigh1.SLDDRW
1_Mechanic/Alexbotmini_V1.0/for_cnc(unchanged)/2D/thigh2.SLDDRW
1_Mechanic/Alexbotmini_V1.0/for_cnc(unchanged)/2D/top.SLDDRW
1_Mechanic/Alexbotmini_V1.0/for_cnc(unchanged)/3D/calf1 - 副本.SLDPRT
1_Mechanic/Alexbotmini_V1.0/for_cnc(unchanged)/3D/calf1.SLDPRT
1_Mechanic/Alexbotmini_V1.0/for_cnc(unchanged)/3D/crotch.SLDPRT
1_Mechanic/Alexbotmini_V1.0/for_cnc(unchanged)/3D/fsa45_30_output.SLDPRT
1_Mechanic/Alexbotmini_V1.0/for_cnc(unchanged)/3D/fsa60_43e_output.SLDPRT
1_Mechanic/Alexbotmini_V1.0/for_cnc(unchanged)/3D/fsa80_29e_output.SLDPRT
1_Mechanic/Alexbotmini_V1.0/for_cnc(unchanged)/3D/fsa80_29e_output_long.SLDPRT
1_Mechanic/Alexbotmini_V1.0/for_cnc(unchanged)/3D/knee.SLDPRT
1_Mechanic/Alexbotmini_V1.0/for_cnc(unchanged)/3D/thigh1.SLDPRT
1_Mechanic/Alexbotmini_V1.0/for_cnc(unchanged)/3D/thigh2.SLDPRT
1_Mechanic/Alexbotmini_V1.0/for_cnc(unchanged)/step/calf1 - 副本.step
1_Mechanic/Alexbotmini_V1.0/wholebody/calf1 - 副本.SLDPRT
3_Walk and trot/humanoid-gym/resources/robots/XBot/meshes/base_link.STL
3_Walk and trot/humanoid-gym/resources/robots/XBot/meshes/left_ankle_pitch_linkage1_link.STL
3_Walk and trot/humanoid-gym/resources/robots/XBot/meshes/left_ankle_pitch_motor1_link.STL
3_Walk and trot/humanoid-gym/resources/robots/XBot/meshes/left_arm_base_link.STL
3_Walk and trot/humanoid-gym/resources/robots/XBot/meshes/left_arm_yaw_link.STL
3_Walk and trot/humanoid-gym/resources/robots/XBot/meshes/left_elbow_pitch_link.STL
3_Walk and trot/humanoid-gym/resources/robots/XBot/meshes/left_foot_ee_link.STL
3_Walk and trot/humanoid-gym/resources/robots/XBot/meshes/left_hand_ee_link.STL
3_Walk and trot/humanoid-gym/resources/robots/XBot/meshes/left_hand_index_rota_link2.STL
3_Walk and trot/humanoid-gym/resources/robots/XBot/meshes/left_hand_mid_tip.STL
3_Walk and trot/humanoid-gym/resources/robots/XBot/meshes/left_hand_pinky_link1.STL
3_Walk and trot/humanoid-gym/resources/robots/XBot/meshes/left_hand_pinky_link2.STL
3_Walk and trot/humanoid-gym/resources/robots/XBot/meshes/left_hand_ring_link2.STL
3_Walk and trot/humanoid-gym/resources/robots/XBot/meshes/left_hand_ring_tip.STL
3_Walk and trot/humanoid-gym/resources/robots/XBot/meshes/left_hand_thumb_bend_link.STL
3_Walk and trot/humanoid-gym/resources/robots/XBot/meshes/left_hand_thumb_rota_link1.STL
3_Walk and trot/humanoid-gym/resources/robots/XBot/meshes/left_hand_thumb_rota_link2.STL
3_Walk and trot/humanoid-gym/resources/robots/XBot/meshes/left_hand_thumb_tip.STL
3_Walk and trot/humanoid-gym/resources/robots/XBot/meshes/left_leg_pitch_link.STL
3_Walk and trot/humanoid-gym/resources/robots/XBot/meshes/left_wrist_roll_link.STL
3_Walk and trot/humanoid-gym/resources/robots/XBot/meshes/left_wrist_yaw_link.STL
3_Walk and trot/humanoid-gym/resources/robots/XBot/meshes/neck_pitch_link.STL
3_Walk and trot/humanoid-gym/resources/robots/XBot/meshes/realsense_link.STL
3_Walk and trot/humanoid-gym/resources/robots/XBot/meshes/right_ankle_pitch_linkage1_link.STL
3_Walk and trot/humanoid-gym/resources/robots/XBot/meshes/right_arm_base_link.STL
3_Walk and trot/humanoid-gym/resources/robots/XBot/meshes/right_elbow_yaw_link.STL
3_Walk and trot/humanoid-gym/resources/robots/XBot/meshes/right_foot_ee_link.STL
3_Walk and trot/humanoid-gym/resources/robots/XBot/meshes/right_hand_ee_link.STL
3_Walk and trot/humanoid-gym/resources/robots/XBot/meshes/right_hand_index_bend_link.STL
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
