Alexhuge1/fftai_alexbotmini/3_Walk and trot/humanoid-gym/resources/robots/XBot/urdf/XBot-L.urdf

<?xml version="1.0" encoding="utf-8"?>
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
<robot name="XBot-L">
  <link name="base_link">
    <inertial>
      <origin xyz="-0.0033599 -0.00084664 0.1336" rpy="0 0 0" />
      <mass value="9.9576" />
      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
    </inertial>
    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
  </link>
  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
  <link name="neck_base_link">
    <inertial>
      <origin xyz="3.5639E-05 4.7576E-05 -0.031296" rpy="0 0 0" />
      <mass value="0.61964" />
      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
    </inertial>
    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
  </link>
  <joint name="neck_base_joint" type="fixed">
    <origin xyz="0 0 0.4" rpy="0 0 0" />
    <parent link="base_link" />
    <child link="neck_base_link" />
    <axis xyz="0 0 0" />
  </joint>
  <link name="neck_yaw_link">
    <inertial>
      <origin xyz="0.023237 0.004247 0.035877" rpy="0 0 0" />
      <mass value="0.64979" />
      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
    </inertial>
    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
  </link>
  <joint name="neck_yaw_joint" type="fixed">
    <origin xyz="0 0 0" rpy="0 0 0" />
    <parent link="neck_base_link" />
    <child link="neck_yaw_link" />
    <axis xyz="0 0 1" />
    <limit lower="-1.57" upper="1.57" effort="50" velocity="7" />
    <dynamics damping="0." friction="0." />
  </joint>
  <link name="neck_pitch_link">
    <inertial>
      <origin xyz="-0.0021819 -0.087991 0.00035708" rpy="0 0 0" />
      <mass value="1.3216" />
      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
    </inertial>
    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
  </link>
  <joint name="neck_pitch_joint" type="fixed">
    <origin xyz="0.032 0 0.044" rpy="-1.5708 0 0" />
    <parent link="neck_yaw_link" />
    <child link="neck_pitch_link" />
    <axis xyz="0 0 1" />
    <limit lower="-0.44" upper="0.44" effort="50" velocity="7" />
    <dynamics damping="0." friction="0." />
  </joint>
  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
  <link name="realsense_link">
    <inertial>
      <origin xyz="0.047424 0.00014285 -0.0082421" rpy="0 0 0" />
      <mass value="0.076907" />
      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
    </inertial>
    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
  </link>
  <joint name="realsense_joint" type="fixed">
    <origin xyz="0.066371 -0.12536 0.0475" rpy="0.34907 1.5708 0" />
    <parent link="neck_pitch_link" />
    <child link="realsense_link" />
    <axis xyz="0 0 0" />
  </joint>
  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
  <link name="left_arm_base_link">
    <inertial>
      <origin xyz="4.3007E-05 -0.0002119 0.15272" rpy="0 0 0" />
      <mass value="0.71484" />
      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
    </inertial>
    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
  </link>
  <joint name="left_arm_base_joint" type="fixed">
    <origin xyz="0 0 0.2885" rpy="-1.5708 -1.5708 0" />
    <parent link="base_link" />
    <child link="left_arm_base_link" />
    <axis xyz="0 0 0" />
  </joint>
  <link name="left_shoulder_pitch_link">
    <inertial>
      <origin xyz="3.5013E-05 -0.0038729 -0.011871" rpy="0 0 0" />
      <mass value="0.90505" />
      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
    </inertial>
    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
  </link>
  <joint name="left_shoulder_pitch_joint" type="fixed">
    <origin xyz="0 0 0.2635" rpy="0 0 0" />
    <parent link="left_arm_base_link" />
    <child link="left_shoulder_pitch_link" />
    <axis xyz="0 0 1" />
    <limit lower="-3.14" upper="1.4" effort="80" velocity="7" />
    <dynamics damping="0." friction="0." />
  </joint>
  <link name="left_shoulder_roll_link">
    <inertial>
      <origin xyz="-5.3445E-05 -0.065465 0.00044459" rpy="0 0 0" />
      <mass value="0.72803" />
      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
    </inertial>
    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
  </link>
  <joint name="left_shoulder_roll_joint" type="fixed">
    <origin xyz="0 0 0" rpy="-1.5708 -1.5708 0" />
    <parent link="left_shoulder_pitch_link" />
    <child link="left_shoulder_roll_link" />
    <axis xyz="0 0 -1" />
    <limit lower="-2.79" upper="0.37" effort="80" velocity="7" />
    <dynamics damping="0." friction="0." />
  </joint>
  <link name="left_arm_yaw_link">
    <inertial>
      <origin xyz="-0.00064229 0.0042682 -0.011976" rpy="0 0 0" />
      <mass value="0.6767" />
      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
    </inertial>
    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
  </link>
  <joint name="left_arm_yaw_joint" type="fixed">
    <origin xyz="0 -0.1905 0" rpy="1.5708 -1.5708 0" />
    <parent link="left_shoulder_roll_link" />
    <child link="left_arm_yaw_link" />
    <axis xyz="0 0 1" />
    <limit lower="-2.09" upper="2.09" effort="50" velocity="7" />
    <dynamics damping="0." friction="0." />
  </joint>
  <link name="left_elbow_pitch_link">
    <inertial>
      <origin xyz="-4.1786E-05 0.063355 0.00048573" rpy="0 0 0" />
      <mass value="0.64825" />
      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
    </inertial>
    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
  </link>
  <joint name="left_elbow_pitch_joint" type="fixed">
    <origin xyz="0 0 0" rpy="1.5708 0 0" />
    <parent link="left_arm_yaw_link" />
    <child link="left_elbow_pitch_link" />
    <axis xyz="0 0 -1" />
    <limit lower="-0.26" upper="2.18" effort="50" velocity="7" />
    <dynamics damping="0." friction="0." />
  </joint>
  <link name="left_elbow_yaw_link">
    <inertial>
      <origin xyz="-0.0001806 0.0042708 -0.0077002" rpy="0 0 0" />
      <mass value="0.64989" />
      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
    </inertial>
    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
  </link>
  <joint name="left_elbow_yaw_joint" type="fixed">
    <origin xyz="0 0.16 0" rpy="-1.5708 0 0" />
    <parent link="left_elbow_pitch_link" />
    <child link="left_elbow_yaw_link" />
    <axis xyz="0 0 1" />
    <limit lower="-2.09" upper="2.09" effort="50" velocity="7" />
    <dynamics damping="0." friction="0." />
  </joint>
  <link name="left_wrist_roll_link">
    <inertial>
      <origin xyz="-5.7422E-05 -0.062427 -0.00035934" rpy="0 0 0" />
      <mass value="0.63795" />
      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
    </inertial>
    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
  </link>
  <joint name="left_wrist_roll_joint" type="fixed">
    <origin xyz="0 0 0" rpy="-1.5708 0 0" />
    <parent link="left_elbow_yaw_link" />
    <child link="left_wrist_roll_link" />
    <axis xyz="0 0 1" />
    <limit lower="-1.92" upper="1.92" effort="50" velocity="7" />
    <dynamics damping="0." friction="0." />
  </joint>
  <link name="left_wrist_yaw_link">
    <inertial>
      <origin xyz="2.3347E-07 -0.00026089 0.11621" rpy="0 0 0" />
      <mass value="0.083273" />
      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
    </inertial>
    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
  </link>
  <joint name="left_wrist_yaw_joint" type="fixed">
    <origin xyz="0 0 0" rpy="1.5708 0 0" />
    <parent link="left_wrist_roll_link" />
    <child link="left_wrist_yaw_link" />
    <axis xyz="0 0 1" />
    <limit lower="-2.09" upper="2.09" effort="50" velocity="7" />
    <dynamics damping="0." friction="0." />
  </joint>
    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
  <link name="right_arm_base_link">
    <inertial>
      <origin xyz="4.3007E-05 -0.0002119 0.15272" rpy="0 0 0" />
      <mass value="0.71484" />
      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
    </inertial>
    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
  </link>
  <joint name="right_arm_base_joint" type="fixed">
    <origin xyz="0 0 0.2885" rpy="1.5708 -1.5708 0" />
    <parent link="base_link" />
    <child link="right_arm_base_link" />
    <axis xyz="0 0 0" />
  </joint>
  <link name="right_shoulder_pitch_link">
    <inertial>
      <origin xyz="-1.5908E-05 0.0038729 -0.012191" rpy="0 0 0" />
      <mass value="0.90505" />
      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
    </inertial>
    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
  </link>
  <joint name="right_shoulder_pitch_joint" type="fixed">
    <origin xyz="0 0 0.2635" rpy="0 0 0" />
    <parent link="right_arm_base_link" />
    <child link="right_shoulder_pitch_link" />
    <axis xyz="0 0 1" />
    <limit lower="-1.4" upper="3.14" effort="80" velocity="7" />
    <dynamics damping="0." friction="0." />
  </joint>
  <link name="right_shoulder_roll_link">
    <inertial>
      <origin xyz="5.3331E-05 -0.065465 -0.00044443" rpy="0 0 0" />
      <mass value="0.72803" />
      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
    </inertial>
    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
  </link>
  <joint name="right_shoulder_roll_joint" type="fixed">
    <origin xyz="0 0 0" rpy="-1.5708 -1.5708 0" />
    <parent link="right_shoulder_pitch_link" />
    <child link="right_shoulder_roll_link" />
    <axis xyz="0 0 1" />
    <limit lower="-0.37" upper="2.79" effort="80" velocity="7" />
    <dynamics damping="0." friction="0." />
  </joint>
  <link name="right_arm_yaw_link">
    <inertial>
      <origin xyz="-0.00088723 -0.0040764 -0.011947" rpy="0 0 0" />
      <mass value="0.67669" />
      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
    </inertial>
    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
  </link>
  <joint name="right_arm_yaw_joint" type="fixed">
    <origin xyz="0 -0.1905 0" rpy="1.5708 1.5708 0" />
    <parent link="right_shoulder_roll_link" />
    <child link="right_arm_yaw_link" />
    <axis xyz="0 0 1" />
    <limit lower="-2.09" upper="2.09" effort="50" velocity="7" />
    <dynamics damping="0." friction="0." />
  </joint>
  <link name="right_elbow_pitch_link">
    <inertial>
      <origin xyz="-5.6114E-05 0.063356 -0.00046067" rpy="0 0 0" />
      <mass value="0.64824" />
      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
    </inertial>
    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
  </link>
  <joint name="right_elbow_pitch_joint" type="fixed">
    <origin xyz="0 0 0" rpy="1.5708 0 0" />
    <parent link="right_arm_yaw_link" />
    <child link="right_elbow_pitch_link" />
    <axis xyz="0 0 1" />
    <limit lower="-2.18" upper="0.26" effort="50" velocity="7" />
    <dynamics damping="0." friction="0." />
  </joint>
  <link name="right_elbow_yaw_link">
    <inertial>
      <origin xyz="9.9183E-05 -0.0042397 -0.0078479" rpy="0 0 0" />
      <mass value="0.6519" />
      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
    </inertial>
    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
  </link>
  <joint name="right_elbow_yaw_joint" type="fixed">
    <origin xyz="0 0.16 0" rpy="-1.5708 0 0" />
    <parent link="right_elbow_pitch_link" />
    <child link="right_elbow_yaw_link" />
    <axis xyz="0 0 1" />
    <limit lower="-2.09" upper="2.09" effort="50" velocity="7" />
    <dynamics damping="0." friction="0." />
  </joint>
  <link name="right_wrist_roll_link">
    <inertial>
      <origin xyz="5.6478E-05 -0.062427 0.00035729" rpy="0 0 0" />
      <mass value="0.63795" />
      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
    </inertial>
    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
  </link>
  <joint name="right_wrist_roll_joint" type="fixed">
    <origin xyz="0 0 0" rpy="-1.5708 0 0" />
    <parent link="right_elbow_yaw_link" />
    <child link="right_wrist_roll_link" />
    <axis xyz="0 0 -1" />
    <limit lower="-1.92" upper="1.92" effort="50" velocity="7" />
    <dynamics damping="0." friction="0." />
  </joint>
  <link name="right_wrist_yaw_link">
    <inertial>
      <origin xyz="-8.1679E-08 0.00026081 0.11621" rpy="0 0 0" />
      <mass value="0.083273" />
      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
    </inertial>
    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
  </link>
  <joint name="right_wrist_yaw_joint" type="fixed">
    <origin xyz="0 0 0" rpy="1.5708 0 0" />
    <parent link="right_wrist_roll_link" />
    <child link="right_wrist_yaw_link" />
    <axis xyz="0 0 1" />
    <limit lower="-2.09" upper="2.09" effort="50" velocity="7" />
    <dynamics damping="0." friction="0." />
  </joint>

  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 
  <link name="waist_yaw_link">
    <inertial>
      <origin xyz="0.0018236 3.106E-08 0.015461" rpy="0 0 0" />
      <mass value="1.9214" />
      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
    </inertial>
    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
  </link>
  <joint name="waist_yaw_joint" type="fixed">
    <origin xyz="0 0 -0.0975" rpy="0 0 0" />
    <parent link="base_link" />
    <child link="waist_yaw_link" />
    <axis xyz="0 0 -1" />
    <limit lower="-1.57" upper="1.57" effort="100" velocity="12" />
    <dynamics damping="0." friction="0." />
  </joint>
  <link name="waist_roll_link">
    <inertial>
      <origin xyz="-8.7577E-07 -0.020553 -0.088247" rpy="0 0 0" />
      <mass value="5.1053" />
      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
    </inertial>
    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
  </link>
  <joint name="waist_roll_joint" type="fixed">
    <origin xyz="0 0 0" rpy="1.5708 0 1.5708" />
    <parent link="waist_yaw_link" />
    <child link="waist_roll_link" />
    <axis xyz="0 0 -1" />
    <limit lower="-0.26" upper="0.26" effort="100" velocity="12" />
    <dynamics damping="0." friction="0." />
  </joint>

    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 
  <link name="left_leg_roll_link">
    <inertial>
      <origin xyz="-0.0048592 -0.00012591 -0.0028089" rpy="0 0 0" />
      <mass value="1.7968" />
      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
    </inertial>
    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
  </link>
  <joint name="left_leg_roll_joint" type="revolute">
    <origin xyz="0.117 -0.032 0" rpy="0 0 -1.5708" />
    <parent link="waist_roll_link" />
    <child link="left_leg_roll_link" />
    <axis xyz="0 0 1" />
    <limit lower="-0.44" upper="1.57" effort="100" velocity="12" />
    <dynamics damping="0." friction="0." />
  </joint>
  <link name="left_leg_yaw_link">
    <inertial>
      <origin xyz="-0.0013538 0.014654 0.077538" rpy="0 0 0" />
      <mass value="0.61484" />
      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
    </inertial>
    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
  </link>
  <joint name="left_leg_yaw_joint" type="revolute">
    <origin xyz="0 0 0" rpy="3.1416 -1.5708 0" />
    <parent link="left_leg_roll_link" />
    <child link="left_leg_yaw_link" />
    <axis xyz="0 0 1" />
    <limit lower="-1.05" upper="1.05" effort="100" velocity="12" />
    <dynamics damping="0." friction="0." />
  </joint>
  <link name="left_leg_pitch_link">
    <inertial>
      <origin xyz="-0.0027612 -0.078535 -0.0083028" rpy="0 0 0" />
      <mass value="6.0376" />
      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
    </inertial>
    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
  </link>
  <joint name="left_leg_pitch_joint" type="revolute">
    <origin xyz="0 0 0.1455" rpy="-1.5708 0.5236 0" />
    <parent link="left_leg_yaw_link" />
    <child link="left_leg_pitch_link" />
    <axis xyz="0 0 -1" />
    <limit lower="-1.57" upper="1.31" effort="250" velocity="12" />
    <dynamics damping="0." friction="0." />
  </joint>
  <link name="left_knee_link">
    <inertial>
      <origin xyz="0.015712 -0.10775 6.6184E-06" rpy="0 0 0" />
      <mass value="2.2288" />
      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
    </inertial>
    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
  </link>
  <joint name="left_knee_joint" type="revolute">
    <origin xyz="0 -0.32 0" rpy="0 0 -1.0472" />
    <parent link="left_leg_pitch_link" />
    <child link="left_knee_link" />
    <axis xyz="0 0 1" />
    <limit lower="-1.05" upper="1.1" effort="250" velocity="12" />
    <dynamics damping="0." friction="0." />
  </joint>
  <link name="left_ankle_pitch_link">
    <inertial>
      <origin xyz="-7.8974E-09 3.999E-08 1.2906E-15" rpy="0 0 0" />
      <mass value="0.043455" />
      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
    </inertial>
    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
  </link>
  <joint name="left_ankle_pitch_joint" type="revolute">
    <origin xyz="0 -0.32 0" rpy="3.1416 0 0.5236" />
    <parent link="left_knee_link" />
    <child link="left_ankle_pitch_link" />
    <axis xyz="0 0 1" />
    <limit lower="-0.7" upper="0.87" effort="100" velocity="12" />
    <dynamics damping="0." friction="0.1" />
  </joint>
  <link name="left_ankle_roll_link">
    <inertial>
      <origin xyz="-1.1259E-06 -0.033529 0.02588" rpy="0 0 0" />
      <mass value="0.34252" />
      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
    </inertial>
    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
  </link>
  <joint name="left_ankle_roll_joint" type="revolute">
    <origin xyz="0 0 0" rpy="0 -1.5708 3.1416" />
    <parent link="left_ankle_pitch_link" />
    <child link="left_ankle_roll_link" />
    <axis xyz="0 0 1" />
    <limit lower="-0.44" upper="0.44" effort="100" velocity="12" />
    <dynamics damping="0." friction="0.1" />
  </joint>
  <link name="left_foot_ee_link">
    <inertial>
      <origin xyz="8.9304E-15 -2.7756E-16 0.0055" rpy="0 0 0" />
      <mass value="0.000975" />
      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
    </inertial>
    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
  </link>
  <joint name="left_foot_ee_joint" type="fixed">
    <origin xyz="0 -0.056 0" rpy="-1.5708 -1.5708 0" />
    <parent link="left_ankle_roll_link" />
    <child link="left_foot_ee_link" />
    <axis xyz="0 0 0" />
  </joint>
  <link name="left_ankle_pitch_motor1_link">
    <inertial>
      <origin xyz="3.0355E-09 -0.01852 0.011673" rpy="0 0 0" />
      <mass value="0.031448" />
      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
    </inertial>
    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
  </link>
  <joint name="left_ankle_pitch_motor1_joint" type="fixed">
    <origin xyz="0.015 -0.052915 -0.023" rpy="3.1416 0 1.7764" />
    <parent link="left_knee_link" />
    <child link="left_ankle_pitch_motor1_link" />
    <axis xyz="0 0 1" />
    <limit lower="-4" upper="4" effort="50" velocity="12" />
    <dynamics damping="0." friction="0." />
  </joint>
  <link name="left_ankle_pitch_linkage1_link">
    <inertial>
      <origin xyz="0.13224 0.0023241 -2.7751E-05" rpy="0 0 0" />
      <mass value="0.066732" />
      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
    </inertial>
    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
  </link>
  <joint name="left_ankle_pitch_linkage1_joint" type="fixed">
    <origin xyz="0 -0.045 0" rpy="0 0 -2.9182" />
    <parent link="left_ankle_pitch_motor1_link" />
    <child link="left_ankle_pitch_linkage1_link" />
    <axis xyz="0 0 1" />
    <limit lower="-4" upper="4" effort="50" velocity="12" />
    <dynamics damping="0." friction="0." />
  </joint>
  <link name="left_ankle_pitch_motor2_link">
    <inertial>
      <origin xyz="-0.01852 1.4156E-09 0.011673" rpy="0 0 0" />
      <mass value="0.031448" />
      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
    </inertial>
    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
  </link>
  <joint name="left_ankle_pitch_motor2_joint" type="fixed">
    <origin xyz="0.0175 -0.12287 0.023" rpy="0 0 0.20869" />
    <parent link="left_knee_link" />
    <child link="left_ankle_pitch_motor2_link" />
    <axis xyz="0 0 1" />
    <limit lower="-4" upper="4" effort="50" velocity="12" />
    <dynamics damping="0." friction="0." />
  </joint>
  <link name="left_ankle_pitch_linkage2_link">
    <inertial>
      <origin xyz="0.097472 -0.002115 -2.9693E-05" rpy="0 0 0" />
      <mass value="0.050552" />
      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
    </inertial>
    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
  </link>
  <joint name="left_ankle_pitch_linkage2_joint" type="fixed">
    <origin xyz="-0.045 0 0" rpy="0 0 -1.8165" />
    <parent link="left_ankle_pitch_motor2_link" />
    <child link="left_ankle_pitch_linkage2_link" />
    <axis xyz="0 0 1" />
    <limit lower="-4" upper="4" effort="50" velocity="12" />
    <dynamics damping="0." friction="0." />
  </joint>
  <link name="left_knee_motor_link">
    <inertial>
      <origin xyz="0.0052166 2.2204E-16 0.023896" rpy="0 0 0" />
      <mass value="0.1157" />
      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
    </inertial>
    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
  </link>
  <joint name="left_knee_motor_joint" type="fixed">
    <origin xyz="-0.006 -0.1401 0" rpy="0 0 0.043633" />
    <parent link="left_leg_pitch_link" />
    <child link="left_knee_motor_link" />
    <axis xyz="0 0 1" />
    <limit lower="-4" upper="4" effort="250" velocity="12" />
    <dynamics damping="0." friction="0." />
  </joint>
  <link name="left_knee_linkage_link">
    <inertial>
      <origin xyz="0.095126 -1.9429E-16 0.017621" rpy="0 0 0" />
      <mass value="0.17943" />
      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
    </inertial>
    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
  </link>
  <joint name="left_knee_linkage_joint" type="fixed">
    <origin xyz="0.045 0 0" rpy="0 0 -1.5811" />
    <parent link="left_knee_motor_link" />
    <child link="left_knee_linkage_link" />
    <axis xyz="0 0 1" />
    <limit lower="-4" upper="4" effort="250" velocity="12" />
    <dynamics damping="0." friction="0." />
  </joint>

  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 
  <link name="right_leg_roll_link">
    <inertial>
      <origin xyz="-0.0048592 0.00012789 -0.0028082" rpy="0 0 0" />
      <mass value="1.7968" />
      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
    </inertial>
    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
  </link>
  <joint name="right_leg_roll_joint" type="revolute">
    <origin xyz="-0.117 -0.032 0" rpy="0 0 -1.5708" />
    <parent link="waist_roll_link" />
    <child link="right_leg_roll_link" />
    <axis xyz="0 0 1" />
    <limit lower="-1.57" upper="0.44" effort="100" velocity="12" />
    <dynamics damping="0." friction="0." />
  </joint>
  <link name="right_leg_yaw_link">
    <inertial>
      <origin xyz="-0.0013541 -0.014654 0.077539" rpy="0 0 0" />
      <mass value="0.61483" />
      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
    </inertial>
    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
  </link>
  <joint name="right_leg_yaw_joint" type="revolute">
    <origin xyz="0 0 0" rpy="3.1416 -1.5708 0" />
    <parent link="right_leg_roll_link" />
    <child link="right_leg_yaw_link" />
    <axis xyz="0 0 1" />
    <limit lower="-1.05" upper="1.05" effort="100" velocity="12" />
    <dynamics damping="0." friction="0." />
  </joint>
  <link name="right_leg_pitch_link">
    <inertial>
      <origin xyz="-0.002765 0.078563 -0.0082909" rpy="0 0 0" />
      <mass value="6.0357" />
      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
    </inertial>
    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
  </link>
  <joint name="right_leg_pitch_joint" type="revolute">
    <origin xyz="0 0 0.1455" rpy="1.5708 0.5236 0" />
    <parent link="right_leg_yaw_link" />
    <child link="right_leg_pitch_link" />
    <axis xyz="0 0 -1" />
    <limit lower="-1.31" upper="1.57" effort="250" velocity="12" />
    <dynamics damping="0." friction="0." />
  </joint>
  <link name="right_knee_link">
    <inertial>
      <origin xyz="0.0157 0.10784 8.556E-05" rpy="0 0 0" />
      <mass value="2.2302" />
      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
    </inertial>
    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
  </link>
  <joint name="right_knee_joint" type="revolute">
    <origin xyz="0 0.32 0" rpy="0 0 1.0472" />
    <parent link="right_leg_pitch_link" />
    <child link="right_knee_link" />
    <axis xyz="0 0 1" />
    <limit lower="-1.1" upper="1.05" effort="250" velocity="12" />
    <dynamics damping="0." friction="0." />
  </joint>
  <link name="right_ankle_pitch_link">
    <inertial>
      <origin xyz="-1.55228117536201E-14 1.11022302462516E-16 -8.32667268468867E-17" rpy="0 0 0" />
      <mass value="0.0990000414231859" />
      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
    </inertial>
    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
  </link>
  <joint name="right_ankle_pitch_joint" type="revolute">
    <origin xyz="0 0.32 0" rpy="3.1416 0 -0.5236" />
    <parent link="right_knee_link" />
    <child link="right_ankle_pitch_link" />
    <axis xyz="0 0 1" />
    <limit lower="-0.87" upper="0.7" effort="100" velocity="12" />
    <dynamics damping="0." friction="0.1" />
  </joint>
  <link name="right_ankle_roll_link">
    <inertial>
      <origin xyz="-1.8693E-06 -0.033529 0.02588" rpy="0 0 0" />
      <mass value="0.34253" />
      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
    </inertial>
    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
  </link>
  <joint name="right_ankle_roll_joint" type="revolute">
    <origin xyz="0 0 0" rpy="0 1.5708 0" />
    <parent link="right_ankle_pitch_link" />
    <child link="right_ankle_roll_link" />
    <axis xyz="0 0 1" />
    <limit lower="-0.44" upper="0.44" effort="100" velocity="12" />
    <dynamics damping="0." friction="0.1" />
  </joint>
  <link name="right_foot_ee_link">
    <inertial>
      <origin xyz="8.9304E-15 0.234 0.0055" rpy="0 0 0" />
      <mass value="0.000975" />
      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
    </inertial>
    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
  </link>
  <joint name="right_foot_ee_joint" type="fixed">
    <origin xyz="0 -0.056 0" rpy="-1.5708 -1.5708 0" />
    <parent link="right_ankle_roll_link" />
    <child link="right_foot_ee_link" />
    <axis xyz="0 0 0" />
  </joint>
  <link name="right_ankle_pitch_motor1_link">
    <inertial>
      <origin xyz="0.01852 -1.4136E-09 0.011673" rpy="0 0 0" />
      <mass value="0.031448" />
      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
    </inertial>
    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
  </link>
  <joint name="right_ankle_pitch_motor1_joint" type="fixed">
    <origin xyz="0.015 0.052915 -0.023" rpy="3.1416 0 2.936" />
    <parent link="right_knee_link" />
    <child link="right_ankle_pitch_motor1_link" />
    <axis xyz="0 0 1" />
    <limit lower="-4" upper="4" effort="50" velocity="12" />
    <dynamics damping="0." friction="0." />
  </joint>
  <link name="right_ankle_pitch_linkage1_link">
    <inertial>
      <origin xyz="0.13224 -0.0023241 -2.7751E-05" rpy="0 0 0" />
      <mass value="0.066732" />
      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
    </inertial>
    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
  </link>
  <joint name="right_ankle_pitch_linkage1_joint" type="fixed">
    <origin xyz="0.045 0 0" rpy="0 0 1.3474" />
    <parent link="right_ankle_pitch_motor1_link" />
    <child link="right_ankle_pitch_linkage1_link" />
    <axis xyz="0 0 1" />
    <limit lower="-4" upper="4" effort="50" velocity="12" />
    <dynamics damping="0." friction="0." />
  </joint>
  <link name="right_ankle_pitch_motor2_link">
    <inertial>
      <origin xyz="0.01852 3.0386E-09 0.011673" rpy="0 0 0" />
      <mass value="0.031448" />
      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
    </inertial>
    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
  </link>
  <joint name="right_ankle_pitch_motor2_joint" type="fixed">
    <origin xyz="0.0175 0.12287 0.023" rpy="0 0 2.9329" />
    <parent link="right_knee_link" />
    <child link="right_ankle_pitch_motor2_link" />
    <axis xyz="0 0 1" />
    <limit lower="-4" upper="4" effort="50" velocity="12" />
    <dynamics damping="0." friction="0." />
  </joint>
  <link name="right_ankle_pitch_linkage2_link">
    <inertial>
      <origin xyz="0.097472 0.002115 -2.9693E-05" rpy="0 0 0" />
      <mass value="0.050552" />
      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
    </inertial>
    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
  </link>
  <joint name="right_ankle_pitch_linkage2_joint" type="fixed">
    <origin xyz="0.045 0 0" rpy="0 0 -1.3251" />
    <parent link="right_ankle_pitch_motor2_link" />
    <child link="right_ankle_pitch_linkage2_link" />
    <axis xyz="0 0 1" />
    <limit lower="-4" upper="4" effort="50" velocity="12" />
    <dynamics damping="0." friction="0." />
  </joint>
  <link name="right_knee_motor_link">
    <inertial>
      <origin xyz="0.0052166 -5.5511E-17 0.023896" rpy="0 0 0" />
      <mass value="0.1157" />
      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
    </inertial>
    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
  </link>
  <joint name="right_knee_motor_joint" type="fixed">
    <origin xyz="-0.006 0.1401 0" rpy="0 0 -0.043633" />
    <parent link="right_leg_pitch_link" />
    <child link="right_knee_motor_link" />
    <axis xyz="0 0 1" />
    <limit lower="-4" upper="4" effort="250" velocity="12" />
    <dynamics damping="0." friction="0." />
  </joint>
  <link name="right_knee_linkage_link">
    <inertial>
      <origin xyz="0.095126 0 0.017621" rpy="0 0 0" />
      <mass value="0.17943" />
      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
    </inertial>
    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
  </link>
  <joint name="right_knee_linkage_joint" type="fixed">
    <origin xyz="0.045 0 0" rpy="0 0 1.5811" />
    <parent link="right_knee_motor_link" />
    <child link="right_knee_linkage_link" />
    <axis xyz="0 0 1" />
    <limit lower="-4" upper="4" effort="250" velocity="12" />
    <dynamics damping="0." friction="0." />
  </joint>

  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
   <link name="left_hand_link">
    <inertial>
      <origin xyz="-0.0004446960229277 0.00281572153706024 -0.0580782201323042" rpy="0 0 0" />
      <mass value="0.0" />
      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
    </inertial>
    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
  </link>
  <joint name="left_hand_fixed_joint" type="fixed">
    <origin xyz="0.0 0 0.1135" rpy="0 3.1415926 3.1415926" />
    <parent link="left_wrist_yaw_link" />
    <child link="left_hand_link" />
  </joint>
  <link name="left_hand_thumb_bend_link">
    <inertial>
      <origin xyz="0.0179386429344406 -0.00293076802887762 0.00225000000000058" rpy="0 0 0" />
      <mass value="0.0" />
      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
    </inertial>
    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
  </link>
  <joint name="left_hand_thumb_bend_joint" type="fixed">
    <origin xyz="0.02503 -0.013 -0.03275" rpy="0 0 0" />
    <parent link="left_hand_link" />
    <child link="left_hand_thumb_bend_link" />
    <axis xyz="0 0 1" />
    <limit lower="-2.0" upper="2.0" effort="0.0" velocity="0.0" />
    <dynamics damping="1" friction="1" />
  </joint>
  <link name="left_hand_thumb_rota_link1">
    <inertial>
      <origin xyz="0.0300000050134235 -1.02163902337971E-10 0.000523850476663684" rpy="0 0 0" />
      <mass value="0.0" />
      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
    </inertial>
    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
  </link>
  <joint name="left_hand_thumb_rota_joint1" type="fixed">
    <origin xyz="0.032173 -0.0035045 0.00225" rpy="0 0 0" />
    <parent link="left_hand_thumb_bend_link" />
    <child link="left_hand_thumb_rota_link1" />
    <axis xyz="0 1 0" />
    <limit lower="-2.0" upper="2.0" effort="0.0" velocity="0.0" />
    <dynamics damping="1" friction="1" />
  </joint>
  <link name="left_hand_thumb_rota_link2">
    <inertial>
      <origin xyz="0.0212369362539032 3.76688634729297E-06 0.000805499878558189" rpy="0 0 0" />
      <mass value="0.0" />
      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
    </inertial>
    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
  </link>
  <joint name="left_hand_thumb_rota_joint2" type="fixed">
    <origin xyz="0.06 0 0" rpy="0 0 0" />
    <parent link="left_hand_thumb_rota_link1" />
    <child link="left_hand_thumb_rota_link2" />
    <axis xyz="0 1 0" />
    <limit lower="-2.0" upper="2.0" effort="0.0" velocity="0.0" />
    <dynamics damping="1" friction="1" />
  </joint>
  <link name="left_hand_thumb_tip">
    <inertial>
      <origin xyz="2.77555756156289E-17 2.18922102668273E-15 -1.17614251671228E-15" rpy="0 0 0" />
      <mass value="0.0" />
      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
    </inertial>
    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
  </link>
  <joint name="left_hand_thumb_tip_joint" type="fixed">
    <origin xyz="0.051457 0 0" rpy="0 0 0" />
    <parent link="left_hand_thumb_rota_link2" />
    <child link="left_hand_thumb_tip" />
    <axis xyz="0 0 0" />
  </joint>
 <link name="left_hand_index_rota_link1">
    <inertial>
      <origin xyz="3.99136486999713E-06 0.00165196763865699 -0.0418295886915027" rpy="0 0 0" />
      <mass value="0.0792128309616318" />
      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
    </inertial>
    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
  </link>
  <joint name="left_hand_index_joint1" type="fixed">
    <origin xyz="0.03583 0 -0.1067" rpy="0 0 0" />
    <parent link="left_hand_link" />
    <child link="left_hand_index_rota_link1" />
    <axis xyz="1 0 0" />
    <limit lower="-1.57" upper="0.24" effort="0.56" velocity="9.82" />
    <dynamics damping="1" friction="1" />
  </joint>
  <link name="left_hand_index_rota_link2">
    <inertial>
      <origin xyz="1.23620880268516E-08 0.000272146436219044 -0.0237372832197695" rpy="0 0 0" />
      <mass value="0.0" />
      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
    </inertial>
    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
  </link>
  <joint name="left_hand_index_joint2" type="fixed">
    <origin xyz="0 0 -0.06675" rpy="0 0 0" />
    <parent link="left_hand_index_rota_link1" />
    <child link="left_hand_index_rota_link2" />
    <axis xyz="1 0 0" />
    <limit lower="-2.0" upper="2.0" effort="0.0" velocity="0.0" />
    <dynamics damping="1" friction="1" />
  </joint>
  <link name="left_hand_index_tip">
    <inertial>
      <origin xyz="0 8.08381139805192E-16 -2.77555756156289E-17" rpy="0 0 0" />
      <mass value="0.0" />
      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
    </inertial>
    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
  </link>
  <joint name="left_hand_index_tip_link" type="fixed">
    <origin xyz="0 0 -0.0532473502691896" rpy="0 0 0" />
    <parent link="left_hand_index_rota_link2" />
    <child link="left_hand_index_tip" />
    <axis xyz="0 0 0" />
  </joint>
  <link name="left_hand_mid_link1">
    <inertial>
      <origin xyz="3.9568861513288E-06 0.00162087664547146 -0.0402835815589407" rpy="0 0 0" />
      <mass value="0.0" />
      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
    </inertial>
    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
  </link>
  <joint name="left_hand_mid_joint1" type="fixed">
    <origin xyz="0.00533 -0.008 -0.1072" rpy="0 0 0" />
    <parent link="left_hand_link" />
    <child link="left_hand_mid_link1" />
    <axis xyz="1 0 0" />
    <limit lower="-2.0" upper="2.0" effort="0.0" velocity="0.0" />
    <dynamics damping="1" friction="1" />
  </joint>
  <link name="left_hand_mid_link2">
    <inertial>
      <origin xyz="1.23620879635342E-08 0.000272146436218273 -0.0237372832197703" rpy="0 0 0" />
      <mass value="0.0" />
      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
    </inertial>
    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
  </link>
  <joint name="left_hand_mid_joint2" type="fixed">
    <origin xyz="0 0 -0.06525" rpy="0 0 0" />
    <parent link="left_hand_mid_link1" />
    <child link="left_hand_mid_link2" />
    <axis xyz="1 0 0" />
    <limit lower="-2.0" upper="2.0" effort="0.0" velocity="0.0" />
    <dynamics damping="1" friction="1" />
  </joint>
  <link name="left_hand_mid_tip">
    <inertial>
      <origin xyz="0 0 0" rpy="0 0 0" />
      <mass value="0.0" />
      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
    </inertial>
    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
  </link>
  <joint name="left_hand_mid_tip_joint" type="fixed">
    <origin xyz="0 0 -0.0532473502691905" rpy="0 0 0" />
    <parent link="left_hand_mid_link2" />
    <child link="left_hand_mid_tip" />
    <axis xyz="0 0 0" />
  </joint>
  <link name="left_hand_ring_link1">
    <inertial>
      <origin xyz="3.95688615132186E-06 0.00162087664547159 -0.0402835815589407" rpy="0 0 0" />
      <mass value="0.0" />
      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
    </inertial>
    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
  </link>
  <joint name="left_hand_ring_joint1" type="fixed">
    <origin xyz="-0.01867 -0.008 -0.1032" rpy="0 0 0" />
    <parent link="left_hand_link" />
    <child link="left_hand_ring_link1" />
    <axis xyz="1 0 0" />
    <limit lower="-2.0" upper="2.0" effort="0.0" velocity="0.0" />
    <dynamics damping="1" friction="1" />
  </joint>
  <link name="left_hand_ring_link2">
    <inertial>
      <origin xyz="1.23620863060059E-08 0.000272146436218248 -0.0237372832197703" rpy="0 0 0" />
      <mass value="0.0" />
      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
    </inertial>
    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
  </link>
  <joint name="left_hand_ring_joint2" type="fixed">
    <origin xyz="0 0 -0.06525" rpy="0 0 0" />
    <parent link="left_hand_ring_link1" />
    <child link="left_hand_ring_link2" />
    <axis xyz="1 0 0" />
    <limit lower="-2.0" upper="2.0" effort="0.0" velocity="0.0" />
    <dynamics damping="1" friction="1" />
  </joint>
  <link name="left_hand_ring_tip">
    <inertial>
      <origin xyz="-3.46944695195361E-18 1.73472347597681E-18 -2.77555756156289E-17" rpy="0 0 0" />
      <mass value="0.0" />
      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
    </inertial>
    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
  </link>
  <joint name="left_hand_ring_tip_link" type="fixed">
    <origin xyz="0 0 -0.0532473502691904" rpy="0 0 0" />
    <parent link="left_hand_ring_link2" />
    <child link="left_hand_ring_tip" />
    <axis xyz="0 0 0" />
  </joint>
  <link name="left_hand_pinky_link1">
    <inertial>
      <origin xyz="3.95688615278944E-06 0.0016208766454722 -0.0402835815589405" rpy="0 0 0" />
      <mass value="0.0" />
      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
    </inertial>
    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
  </link>
  <joint name="left_hand_pinky_joint1" type="fixed">
    <origin xyz="-0.04267 -0.008 -0.0992" rpy="0 0 0" />
    <parent link="left_hand_link" />
    <child link="left_hand_pinky_link1" />
    <axis xyz="1 0 0" />
    <limit lower="-2.0" upper="2.0" effort="0.0" velocity="0.0" />
    <dynamics damping="1" friction="1" />
  </joint>
  <link name="left_hand_pinky_link2">
    <inertial>
      <origin xyz="1.23620888803355E-08 0.000272146436219168 -0.0237372832197701" rpy="0 0 0" />
      <mass value="0.0" />
      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
    </inertial>
    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
  </link>
  <joint name="left_hand_pinky_joint2" type="fixed">
    <origin xyz="0 0 -0.06525" rpy="0 0 0" />
    <parent link="left_hand_pinky_link1" />
    <child link="left_hand_pinky_link2" />
    <axis xyz="1 0 0" />
    <limit lower="-2.0" upper="2.0" effort="0.0" velocity="0.0" />
    <dynamics damping="1" friction="1" />
  </joint>
  <link name="left_hand_pinky_tip">
    <inertial>
      <origin xyz="0 1.73472347597681E-18 -2.77555756156289E-17" rpy="0 0 0" />
      <mass value="0.0" />
      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
    </inertial>
    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
  </link>
  <joint name="left_hand_pinky_tip_link" type="fixed">
    <origin xyz="0 0 -0.0532473502691902" rpy="0 0 0" />
    <parent link="left_hand_pinky_link2" />
    <child link="left_hand_pinky_tip" />
    <axis xyz="0 0 0" />
  </joint>
  <link name="left_hand_ee_link">
    <inertial>
      <origin xyz="5.06494379885543E-19 -0.0300000000000001 -1.38777878078145E-17" rpy="0 0 0" />
      <mass value="0.0" />
      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
    </inertial>
    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
  </link>
  <joint name="left_hand_ee_joint" type="fixed">
    <origin xyz="0 0 -0.08" rpy="0 3.1415926 3.1415926" />
    <parent link="left_hand_link" />
    <child link="left_hand_ee_link" />
    <axis xyz="0 0 0" />
  </joint>
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
