Alexhuge1/fftai_alexbotmini/(commit log)

2024-08-29 add the main part of the project
    [BOM.xlsx, M10导向轴.SLDPRT, M10导向轴_140.SLDPRT, M10导向轴_80.SLDPRT, M4球头.SLDPRT, M5球头.SLDPRT, XBot-L-terrain.xml, XBot-L.urdf]
2024-09-06 1
    1
    [GR1-06-2-048,右脚包胶足撑_copy.SLDASM, GR1-07-2-017-G,脚板连杆座_copy.SLDPRT, GR1-07-2-030,踝十字轴_copy.SLDPRT, GR1-07-2-033,关节延长轴_copy.SLDPRT, GR1-07-2-034-G,脚板十字座_copy.SLDPRT, GR1-07-2-048,左脚包胶足撑_copy.SLDASM, GR1-07-2-049-G,脚板转接件_copy.SLDPRT, GR1-07-2-059-G,脚板连杆座-1_copy.SLDPRT]
2024-11-03 change urdf
    small change in urdf
    [alexbotmini.csv, alexbotmini.urdf]
2024-11-27 add change in cnc
    add change in cnc
    [BOM.xlsx, back.SLDDRW, back.SLDPRT, calf1 - 副本.SLDDRW, calf1 - 副本.SLDPRT, calf1 - 副本.step, calf1.SLDDRW, calf1.SLDPRT]
2024-12-02 change cnc for new motors
    change cnc for new motors
    [crotch.STEP, fsa60_43e_output.STEP, thigh1.STEP, thigh2.SLDPRT, thigh2.STEP]
